trancaalex19/Prelucrarea-mecanic-i-simularea-CAM-pentru-un-cilindru-de-distribu-ie-/Proiect_Pi3.pdf

### Universitatea Nat, ională de S, tiint,ă s, i Tehnologie Politehnica din Bucureşti Facultatea de Inginerie Industrială şi Robotică

Specializarea Informatică Aplicată

# PROIECT DE PROCESE INDUSTRIALE

## Proiectarea procesului de fabricare a produsului: Cilindru de Distribut, ie cu Flans,ă

Student: Trancă Alexandru-Constantin
Grupa: 634 AB
Cadrul didactic: Sergiu TONOIU / Marius LAZAR˘

An univ. 2025-26

# Cuprins

## 1 Proiectare proces de fabricare a produsului

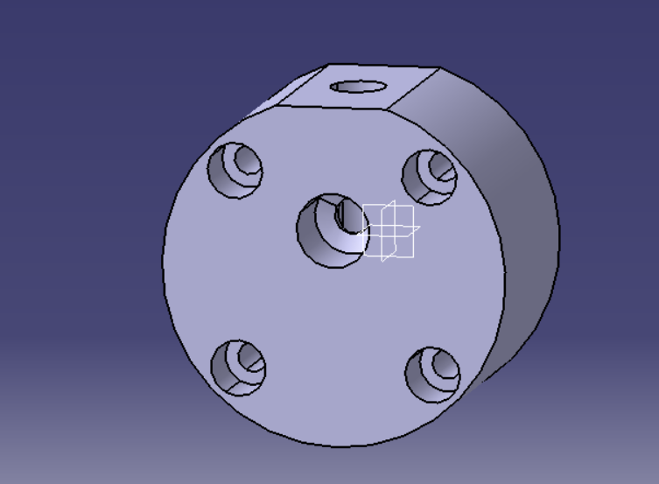
[picture p1: figure]

Figura 1: Model 3D - Cilindru de distribut, ie cu flans,ă

### 1.1 Date init¸iale generale

- Produs: Cilindru de distribut, ie cu flans,ă
- Programa de product, ie: 1250 buc/an
- Unitatea de product, ie: CRYSTAL S.A.
- Obiectiv principal: introducerea unei noi tehnologii
- Fond real de timp: 255 · 1 · 8 = 2040 ore/an
- Cerint,a economică: cost minim de product, ie

## 2 Date constructiv - funct¸ionale

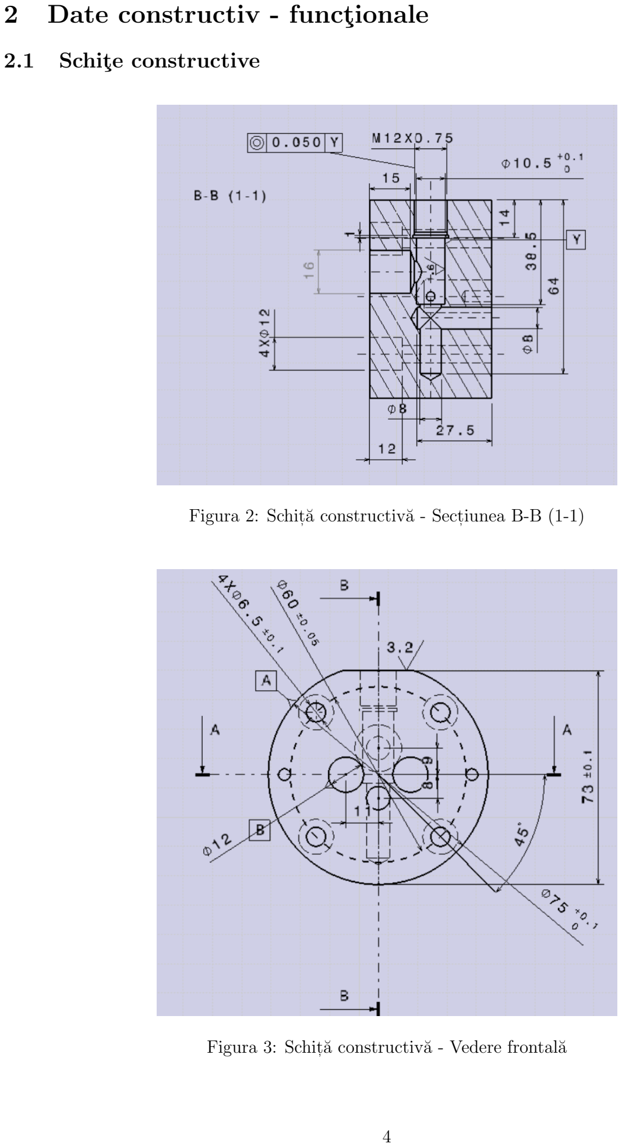
[picture p2: page 5]

### 2.1 Schitȩ constructive

Figura 2: Schit,ă constructivă - Sect, iunea B-B (1-1)

Figura 3: Schit,ă constructivă - Vedere frontală

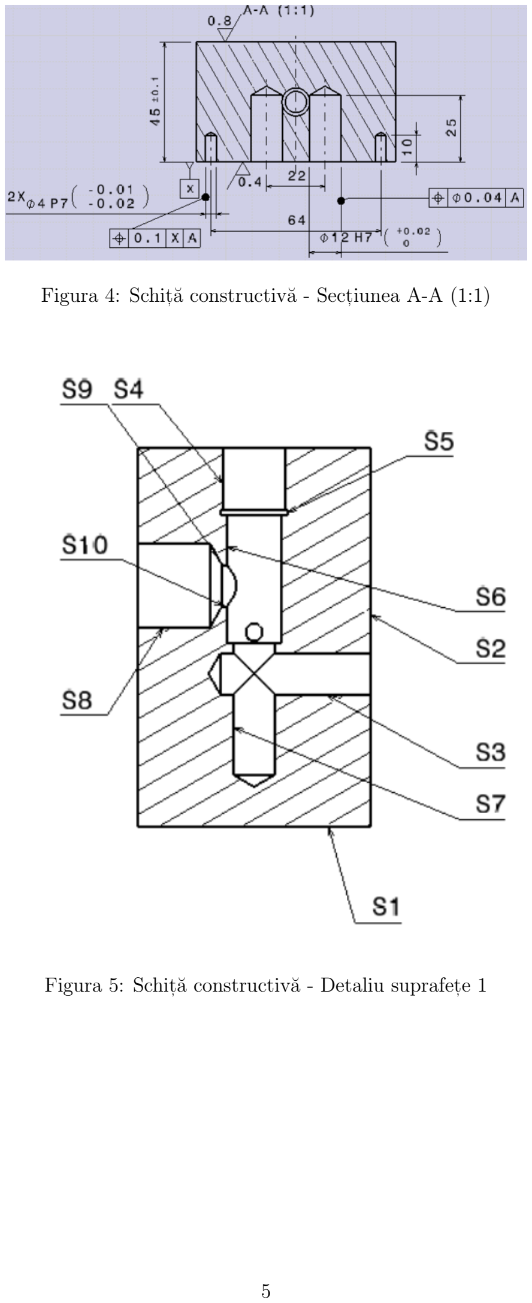
[picture p3: page 6]

Figura 4: Schit,ă constructivă - Sect, iunea A-A (1:1)

Figura 5: Schit,ă constructivă - Detaliu suprafet,e 1

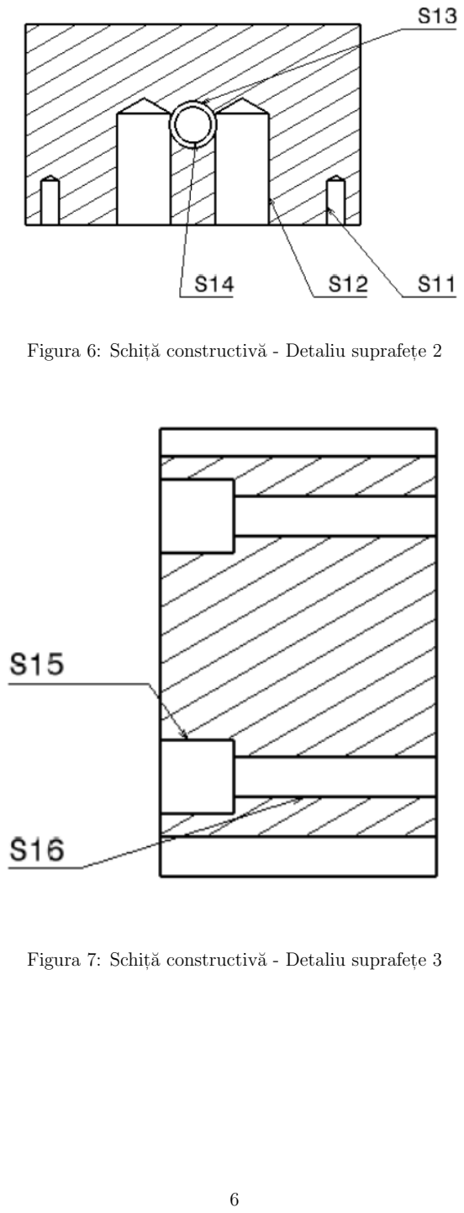
[picture p4: page 7]

Figura 6: Schit,ă constructivă - Detaliu suprafet,e 2

Figura 7: Schit,ă constructivă - Detaliu suprafet,e 3

### 2.2 Caracteristici constructive prescrise

a. Caracteristicile suprafetȩlor
SK | Forma | Precizie dimensională | Prec. formă | Ra | Prec. pozit, ie
S1 | Cilindrică Exteri-oară | 45+0.3 × ϕ75+0.1 −0.3 −0.0 mXm | - | 3.2 N8 | -
S2 | Plană Exterioară | ϕ73+0.1 × ϕ45+0.3 −0.1 −0.3 mXm | - | 0.8 N6 | -
S3 | Cilindrică Interi-oară | ϕ8 +0.2 × ϕ25+0.2 −0.2 −0.2 mXm | - | 6.3 N9 | -
S4 | Filetată Interioară | ϕ12+0.2 × ϕ0.75+0.1 −0.2 −0.1 mXm | - | 6.3 N9 | -
S5 | Cilindrică Interi-oară | ϕ13+0.2 +0.1 × 1 −0.2 −0.1 mXm | - | 6.3 N9 | ⊙|0.050|Y V III
S6 | Cilindrică Interi-oară | ϕ10.5 +0.1 × 24.5 +0.2 −0.0 −0.2 mXm | - | 1.6 N7 | -
S7 | Cilindrică Interi-oară | +0.2 × 26+0.2 ϕ8 −0.2 −0.2 mXm | - | 6.3 N9 | -
S8 | Filetată Interioară | ϕ16+0.2 +0.1 × ϕ1.5 −0.2 −0.1 mXm | - | 6.3 N9 | -
S9 | Conică Interioară | ϕ16+0.2 +0.2 × 8 −0.2 −0.2 mXm | - | 6.3 N9 | -
S10 | Cilindrică Interi-oară | +0.2 +0.2 ϕ8 × 3 −0.2 −0.2 mXm | - | 6.3 N9 | -
2xS11 | Cilindrică Interi-oară | −0.01 −0.02 × 10+0.2 ϕ4 −0.2 p7Xm | - | 6.3 N9 | -
2xS12 | Cilindrică Interi-oară | ϕ12+0.018 × 25+0.2 −0.000 −0.2 h7Xm | - | 6.3 N9 | ⊕|0.04|A V III
S13 | Rază interioară | R10.5 | - | 6.3 N9 | -
S14 | Cilindrică Interi-oară | +0.2 × 26+0.2 ϕ8 −0.2 −0.2 mXm | - | 6.3 N9 | -
4xS15 | Cilindrică Interi-oară | ϕ12+0.2 × 12+0.2 −0.2 −0.2 mXm | - | 6.3 N9 | -
4xS16 | Cilindrică Interi-oară | +0.1 × 33+0.2 ϕ6.5 −0.1 −0.2 mXm | - | 6.3 N9 | -

b. Tabel: Abateri limită pentru dimensiuni liniare cf. ISO 2768 - m
Clasa | Descriere | 0.5 - 6 mm | 6 - 30 mm | 30 - 120 mm | 120 - 400 mm
m | mijlocie | ±0.1 | ±0.2 | ±0.3 | ±0.5
c. Caracteristici de material
- Având în vedere preciziile dimensionale ridicate impuse (trepte de tolerant,ă IT7 s, i IT8), materialul ales este ot,elul de calitate nealiat C45 (echivalent OLC 45).
- Acesta este un ot,el de îmbunătăt, ire care permite obt, inerea unor suprafet,e cu rugozitate foarte mică prin rectificare.
- Compozit, ia chimică: Carbon (C): 0,42-0,50%; Mangan (Mn): 0,50-0,80%; Silicon (Si): max. 0,40%; Crom (Cr): max. 0,40%.
- Structura metalografică: În stare recoaptă: ferito-perlitică. După tratament termic (îmbunătăt, ire): sorbită de revenire, care asigură un echilibru optim între duritate s, i tenacitate, esent, ial pentru ment, inerea preciziei geometrice în timp.
- Proprietăt, i fizico-mecanice: Rezistent,a la tract, iune Rm: 580-700 MPa. Limita de curgere Re: min. 340 MPa. Duritate: aprox. 170-210 HB (stare recoaptă) sau peste 50 HRC (după călire superficială pe suprafet,ele funct, ionale).
- Tratamente termice prescrise: Normalizare: 840 − 880◦C.

Îmbunătăt, ire: Călire la 820 − 860◦C (în apă sau ulei) urmată de revenire la 550 − 660◦C.

d. Masa
•

În cadrul software-ului de modelare 3D (CATIA V5 / Fusion 360), am atribuit reperului materialul C45 (AISI 1045).

- Utilizând funct, ia Properties, au fost determinate caracteristicile fizice bazate pe densitatea de 7, 85 kg/dm³

(0, 00785 g/mm³
).
- Masa piesei este 172 de grame (0.172 kg) s, i a fost determinată cu ajutorul programului Catia V5 folosind unealta Measure Inertia.
- Volumul produsului: 45,04 cm³

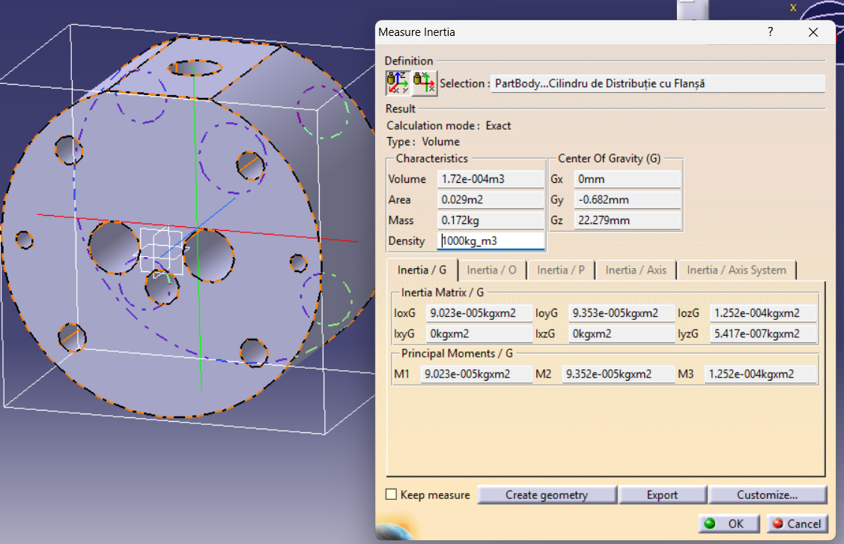
[picture p5: figure]

Figura 8: Determinarea masei utilizând Measure Inertia în CATIA V5

### 2.3 Tehnologicitate

Analiza tehnologicităt, ii piesei din C45 confirmă eficient,a procesului de fabricat, ie propus.
a. Concordant¸a dintre caracteristicile constructive s, i rolul funct¸ional
- Precizia dimensională: Utilizarea tolerant,elor strânse pentru cota fantei 4 P7 (treapta IT7) s, i a găurilor de ϕ12 H7 indică un rol funct, ional critic, piesa fiind destinată unui ansamblu cu ajustaje cu strângere sau centrare precisă.
- Calitatea suprafet,elor: Pentru suprafet,ele de precizie s-a impus o rugozitate de Ra 0,4 sau Ra 0,8. Aceasta este realizabilă prin operat, ii de finisare (rectificare), specifice ot,elului C45.
- Pozit, ia relativă: Tolerant,a de pozit, ie de 0,04 mm sau 0,1 mm fat,ă de baza A este justificată pentru a asigura coaxialitatea sau simetria elementelor fat,ă de axele de referint,ă.
b. Gradul de unificare a caracteristicilor geometrice
- Elemente standardizate: Utilizarea găurilor de ϕ6, 5 (cu tolerant,ă generală ±0.1) permite folosirea sculelor as,chietoare de serie.
- Cerc de divizare (PCD): Dispunerea elementelor pe un cerc de divizare punctat facilitează programarea pe mas, ini CNC în coordonate polare.
- Dimensiuni normale: Cotele liniare au fost alese din şirurile de dimensiuni normale (Anexa I), optimizând utilizarea semifabricatelor standard.
c. Propuneri de eliminare a deficientȩlor s, i concluzii
- Accesibilitatea aşchierii: Geometria permite accesul facil al sculelor pe vederile sect¸ionate (sect, iuni locale de tip breakout), fără necesitatea unor scule speciale.
- Propunere de optimizare: Se recomandă adăugarea unor tes, ituri de 1 × 45◦
la intrarea în
alezajele filetate (ex. M16) s, i la marginile exterioare pentru a facilita asamblarea s, i a proteja filetul de bavuri.

### 2.4 Clasa piesei

Conform desenului de execut, ie s, i caracteristicilor constructive, piesa analizată face parte din clasa elementelor de distribut, ie s, i flanşelor utilizate în cadrul sistemelor hidraulice sau pneumatice. Acest tip de piesă are rolul de a asigura închiderea, etanşarea s, i dirijarea precisă a fluidelor, contribuind la ment, inerea pozit, iei corecte a componentelor din ansamblu. De asemenea, piesa asigură centrarea s, i fixarea rigidă prin intermediul ajustajelor prescrise.

### 2.5 Analiza caracteristicilor funct, ionale ale piesei

### 2.5.1 Rolul funct, ional al piesei

Principalul rol al piesei ”

Cilindru de Distribut, ie cu Flanşă” este de a permite distribut, ia fluidului de lucru s, i de a asigura îmbinarea precisă cu restul ansamblului. Prin intermediul suprafet,elor de montaj (alezajele H7 s, i P7) s, i al găurilor de prindere, piesa se fixează pe corpul sistemului, realizând solidarizarea cu acesta.

### 2.5.2 Rolul funct, ional al suprafet,elor piesei s, i ajustaje prescrise

a) Rolul funct, ional al suprafet,elor piesei
În general, rolul funct, ional al piesei este determinat de rolul funct, ional al suprafet,elor care o compun. Principalele suprafet,e ale piesei s, i rolul acestora sunt prezentate în tabelul următor:
SK | Forma suprafet,ei | Rolul funct, ional
S1 | Cilindrică Exterioară | Suprafat,ă de centrare s, i delimitare construc-tivă a formei piesei.
S2 | Plană Exterioară | Suprafat,ă de sprijin s, i montaj pe corpul an-samblului.
S3, S6, S7, S10, S14 | Cilindrică Interioară | Suprafet,e funct, ionale pentru dirijarea fluidu-lui sau montajul componentelor interne.
S9 | Conică Interioară | Suprafet,e de racordare sau scaune pentru ele-mente de etanşare/supape.
S4, S8 | Filetată Interioară | Suprafet,e de fixare pentru elemente de prin-dere, fitinguri sau accesorii hidraulice.
S5 | Cilindrică Interioară | Suprafet,e tehnologice s, i funct, ionale pentru trecerea fluidului.
2xS11 | Cilindrică/Conică Int. | Suprafet,e de pozit, ionare s, i centrare precisă (s,tifturi de ghidare).
2xS12 | Cilindrică/Conică Int. | Suprafet,e funct, ionale cu tolerant,ă strânsă pentru asamblare s, i etanşare.

SK | Forma suprafet,ei | Rolul funct, ional
4xS15, 4xS16 | Cilindrică Interioară | Suprafet,e de fixare prin şuruburi pentru prin-derea flanşei de corp.
S13 | Rază interioară / De-gajare | Cameră de racordare pentru distribut, ia uni-formă a fluidului către canalele verticale.
S14 | Cilindrică Interioară | Galerie principală de alimentare pentru con-ducerea fluidului de lucru către zona de distribut, ie.
b) Ajustaje prescrise
Alezajele de precizie ϕ12 H7 s, i fantele/găurile ϕ4 P7 sunt critice pentru funct, ionarea sistemului.
- Tolerant,a H7 indică un ajustaj cu joc sau de trecere precisă, permit,ând centrarea corectă a componentelor pereche s, i reducerea frecării în timpul asamblării.
- Tolerant,a P7 indică un ajustaj cu strângere (sau de trecere fixă), utilizat pentru presarea s,tifturilor de centrare, garantând rigiditatea şi ment¸inerea pozit, iei relative.

2.5.3 Concordant¸a dintre caracteristicile prescrise s, i cele impuse de rolul funct¸ional

În urma analizei desenului de execut, ie s-a constatat că majoritatea caracteristicilor dimensionale s, i de precizie sunt în perfectă concordant¸ă cu rolul funct, ional al piesei. Suprafet,ele de asamblare prezintă tolerant,e strânse (IT7) s, i rugozităt, i fine (Ra 0.4, Ra 0.8), în timp ce pentru suprafet,ele de degajare sau constructive, tolerant,ele au fost relaxate. Prin urmare, caracteristicile prescrise sunt rat, ionale s, i corespunzătoare.

### 2.6 Analiza caracteristicilor tehnologice ale piesei

### 2.6.1 Prelucrabilitatea materialului

Materialul impus în construct, ia piesei este ot,el C45, conform standardului SR EN 10083. Acest tip de ot,el prezintă o rezistent,ă mecanică bună, duritate ridicată s, i o bună prelucrabilitate prin as,chiere. Acest material permite realizarea operat, iilor de strunjire, frezare, găurire s, i alezare în condit, ii tehnologice favorabile.

### 2.6.2 Forma constructivă a piesei

Piesa este compusă din forme geometrice relativ simple, principalele suprafet,e fiind cilindrice s, i plane. Cu toate acestea, prezent,a alezajelor radiale s, i a găurilor dispuse pe cercul de divizare impune utilizarea unor mas, ini cu comandă numerică (CNC) cu minim 3 axe, sau centre de strunjire-frezare.

### 2.6.3 Posibilitatea folosirii unor suprafet,e ca bază de referint,ă

În primele operat, ii de prelucrare, bazarea piesei se va realiza pe suprafet,ele cilindrice s, i plane exterioare ale semifabricatului. Ulterior, pentru obt, inerea preciziei de pozit, ie (0.04, 0.050), piesa va fi fixată utilizând suprafet,ele deja prelucrate (ex: suprafat,a frontală S5 s, i diametrul exterior S1), care vor servi drept baze tehnologice principale.

### 2.6.4 Analiza prescrierii rat, ionale a tolerant,elor

Tolerant,ele dimensionale sunt prescrise în mod rat, ional, fiind aplicate restrictiv doar pe suprafet,ele funct¸ionale (H7, P7). Suprafet,ele constructive exterioare au tolerant,e mai largi, ceea ce conduce la simplificarea procesului tehnologic, scăderea timpului de prelucrare s, i reducerea costurilor de fabricat, ie.

### 2.7 Gradul de unificare al caracteristicilor constructive

Gradul de unificare reprezintă un indice de tehnologicitate utilizat pentru aprecierea nivelului de standardizare al elementelor. Piesa are un grad excelent de unificare: găurile de ϕ6.5, filetele metrice fine standardizate s, i unghiurile de tes, ire de 120◦ permit utilizarea sculelor as,chietoare de serie (burghie, tarozi, tes, itoare standard), indicând o tehnologicitate favorabilă.

## 3 Semifabricare s, i prelucrări

### 3.1 Proiectarea semifabricatului

### 3.1.1 a) Alegerea metodei s, i justificarea procedeului

Având în vedere materialul Ot,el C45 s, i volumul de product, ie de serie medie (1250 buc/an), metoda optimă de obt, inere a semifabricatului este deformarea plastică, mai exact procedeul de matrit,are la cald în matrit,e închise.
Spre deosebire de piesele turnate din fontă, ot,elul carbon de calitate C45 se pretează excelent la deformare plastică la cald. Alegerea matrit,ării este justificată din următoarele considerente tehnico-economice:
- Precizie geometrică ridicată: Asigură obt, inerea unei configurat, ii foarte apropiate de forma finală a piesei (cilindru cu flans,ă), reducând astfel semnificativ adaosurile de prelucrare s, i volumul de material îndepărtat prin as,chiere ulterioară.
- Caracteristici mecanice superioare: Prin presarea materialuluiîn matrit,ă se obt, ine o structură internă omogenă s, i o fibrare continuă, care urmăres,te conturul piesei. Acest aspect cres,te rezistent,a la uzură s, i oboseală, esent, ială pentru rolul funct, ional al cilindrului de distribut, ie.
- Eficient,ă economică: Pentru seria de 1250 bucăt, i/an, costul de proiectare s, i execut, ie a matrit,elor se amortizează rapid prin economia de material s, i reducerea drastică a timpilor auxiliari s, i de as,chiere pe mas, inile CNC.

În faza de fundamentare a deciziei tehnologice, au fost luate în calcul două variante tehnic acceptabile pentru obt, inerea semifabricatului. Acestea sunt detaliate în Tabelul 3.1.a. S-a optat definitiv pentru Varianta 1.

Tabela 3: Tab. 3.1.a Metoda s, i procedeul de semifabricare

Varianta | Tip semifabricat | Metoda de semifa-bricare | Procedeu de semifa-bricare
1 | Cu adaos mare (Precizie normală) | Deformare plastică | Matrit,are la cald pe cio-can
2 | Cu adaos foarte mare (Precizie brută) | Deformare plastică | Forjare liberă pe ciocan

### 3.1.2 b) Reprezentarea grafică a semifabricatului

Pentru obt, inerea formei brute s-au stabilit adaosurile de prelucrare, adaosurile tehnologice (pentru suprafet,ele care se vor prelucra din plin, cum ar fi alezajele mici sau filetele) s, i razele de racordare constructive. Planul de separat, ie al matrit,ei a fost plasat la nivelul sect, iunii maxime (flans,a). În figurile de mai jos sunt prezentate schit,ele tehnologice ale semifabricatului brut matrit,at.

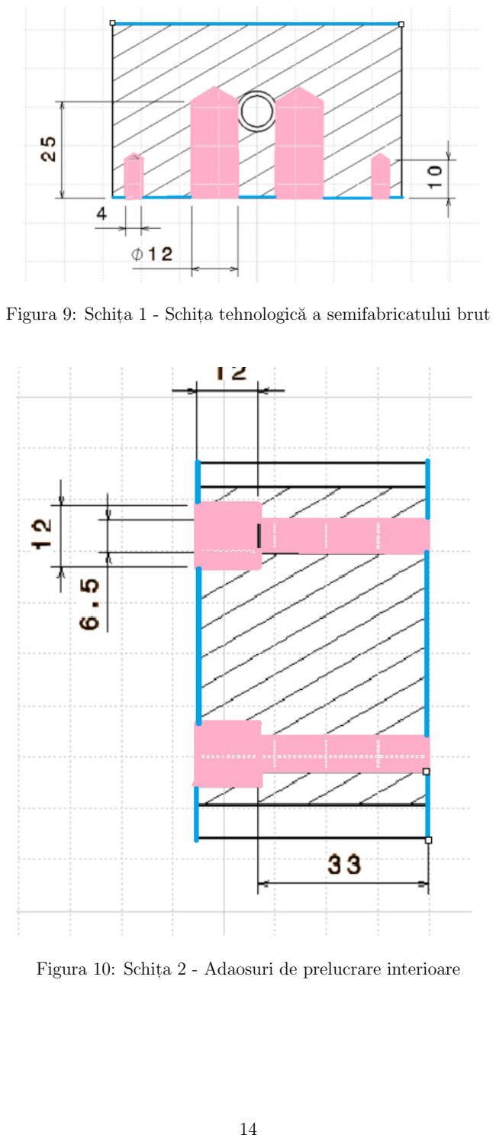
[picture p6: page 15]

Figura 9: Schit,a 1 - Schit,a tehnologică a semifabricatului brut

Figura 10: Schit,a 2 - Adaosuri de prelucrare interioare

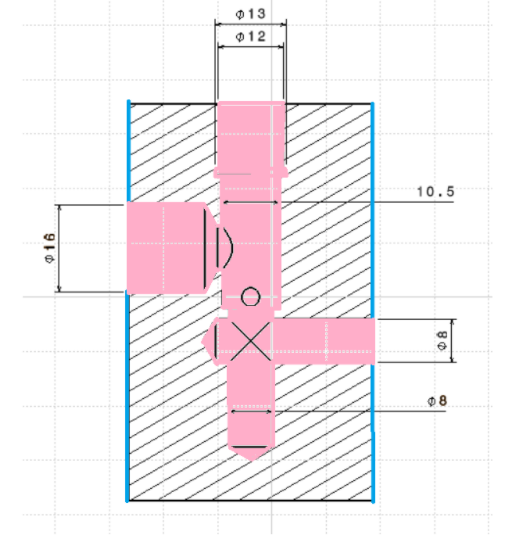
[picture p7: figure]

Figura 11: Schit,a 3 - Definirea cotelor brute finale

### 3.1.3 c) Determinarea adaosurilor de prelucrare

În Tabelul 3.1.b se prezintă principalele dimensiuni ale suprafet,elor semifabricatului cu adaosurile specifice matrit,ării pe ciocan (conform SR EN 10243), metodă aleasă pentru reducerea costurilor de pregătire a fabricat, iei.

Tab. 3.1.b Caracteristicile semifabricatului

Suprafat,a | Dimensiunea pre-scrisă piesei [mm] | Adaosul de prelu-crare total [mm] | Dimensiunea pre-scrisă semifabricatu-lui [mm]
Lungime to-tală | 64 | - | Se prelucrează din plin
Găuri de de-gajare | ϕ16, ϕ8 | - | Se prelucrează din plin
Gaură de fi-xare | ϕ4 | - | Se prelucrează din plin
Gaură de fi-xare | ϕ12, ϕ4, filet M12 | 2 pe rază | ϕ12+0.018 −0.000

### 3.2 Prelucrări

### 3.2.1 Stabilirea succesiunii de prelucrări

a) Date init, iale:
- Tipul s, i caracteristicile suprafet,elor: Conform analizei suprafet,elor (Tabelul caracteristicilor SK) din desenul de execut, ie (suprafet,e cilindrice exterioare, interioare de ghidare, suprafet,e plane de as,ezare s, i suprafet,e filetate).
- Precizia prescrisă fiecărei suprafet,e: Conform desenului de execut, ie, sunt impuse tolerant,e dimensionale strânse, în special clasa H7 (pentru alezajul central ϕ12) s, i clasa P7 (pentru găurile de fixare ϕ4), dar s, i rugozităt, i foarte fine de până la Ra 0.4 µm (pentru cota H7) s, i Ra 0.8 µm (pentru planul flans,ei).
- Materialul: Ot,el de calitate nealiat C45, care prezintă o bună prelucrabilitate pentru atingerea rugozităt, ilor impuse.
- Programa de product, ie: 1250 buc/an (serie mijlocie).
- Semifabricat: Obt, inut prin deformare plastică (Matrit,are la cald pe ciocan - varianta cu adaos mare), conform subcapitolului precedent. De ment, ionat că alezajele de precizie s, i filetele vor fi prelucrate din plin, neavând goluri în semifabricatul brut.
- Metodologia de stabilire: S-a renunt,at la metoda analitică a coeficient, ilor de precizie în favoarea stabilirii directe a succesiunii operat, iilor, utilizând preciziile economice ale metodelor de prelucrare prin as,chiere (conform tabelelor de recomandări tehnologice).
b) Stabilirea prelucrărilor necesare (Metoda preciziei economice)
Pornind de la starea suprafet,elor semifabricatului matrit,at, prelucrările au fost stabilite astfel încât să se atingă treptat clasa de tolerant,ă s, i rugozitatea finală cerută pe desen. Din perspectiva prelucrării pe centre CNC moderne, s-au respectat următoarele recomandări tehnologice stricte pentru prelucrarea ot,elului C45:
- Pentru suprafet,ele cilindrice s, i plane de precizie normală, se va aplica o prelucrare de degros,are pentru îndepărtarea crustei de matrit,are, urmată de o trecere de finisare.
- Pentru suprafat,a frontală de as,ezare (S2), unde este impusă o rugozitate fină de Ra 0.8 µm, succesiunea necesită 3 treceri: Strunjire frontală de degros,are, semifinisare s, i o trecere finală de finisare.
- Pentru alezajele de mare precizie (ϕ12 H7 s, i ϕ4 P7), trecerea de la material plin la cota finală necesită prelucrări succesive pentru a garanta respectarea tolerant,ei s, i rugozităt, ii fine (Ra 0.4): Găurire cu burghiu subcotat, urmată de Alezare de degros,are s, i Alezare de precizie (finisare).
- Pentru suprafet,ele filetate (M12 × 0.75 s, i M16 × 1.5), procesul va fi: Găurire la diametrul prescris, tes, ire de intrare, urmată de Filetare cu tarod.
- Suprafet,ele de degajare interioare conice s, i razele (S9, S13) se vor prelucra prin strunjire de conturare (interpolare CNC pe 2 axe).

În Tabelul 3.2.1 se prezintă sinteza prelucrărilor necesare pentru îndeplinirea caracteristicilor tuturor celor 16 suprafet,e ale cilindrului de distribut, ie.

Tab. 3.2.1 Stabilirea prelucrărilor principale pentru toate suprafet,ele

Nr. Supr. | Forma nominală | Prel. 1 | Prelucrări / Ra [µm] Prel. 2 | Prel. 3
S1 | Suprafat,ă cilindrică exterioară (ϕ75) | Strunjire exterioară de degros,are 12.5 IT10 | Strunjire exterioară de finisare 3.2 IT9 | -
S2 | Suprafat,ă plană ex-terioară (Flans,ă) | Strunjire frontală de degros,are 12.5 IT10 | Strunjire frontală de semifinisare 3.2 IT9 | Strunjire fron-tală de finisare 0.8 IT7
S3 | Suprafat,ă cilindrică interioară (ϕ25) | Găurire din plin / Lărgire 12.5 IT12 | Strunjire interioară de finisare 6.3 IT10 | -
S4, S8 | Suprafet,e filetate interioare (M12, M16) | Găurire din plin (ϕ11.2 / ϕ14.5) 12.5 IT12 | Tes, ire intrare 1 × 45◦ 6.3 IT10 | Filetare cu tarod 3.2 IT9
S5 | Suprafat,ă cilindrică interioară (ϕ13) | Găurire din plin 12.5 IT12 | Strunjire interioară de degros,are 6.3 IT10 | -
S6 | Suprafat,ă cilindrică interioară (ϕ10.5) | Găurire din plin (ϕ10) 12.5 IT12 | Strunjire interioară de finisare 1.6 IT8 | -
S7, S10, S14 | Suprafet,e cilindrice interioare (ϕ8) | Găurire din plin (ϕ8) 6.3 IT11 | - -
S9 | Suprafat,ă conică interioară | Strunjire conică de degros,are 12.5 IT10 | Strunjire conică de finisare 6.3 IT9 | -
S11 (2x) | Suprafat,ă cilindrică interioară (ϕ4 P7) | Găurire din plin (ϕ3.8) 12.5 IT12 | Alezare de finisare 1.6 IT7(P7) | -

Nr. Supr. | Forma nominală | Prel. 1 | Prelucrări / Ra [µm] Prel. 2 | Prel. 3
S12 (2x) | Suprafat,ă cilindrică interioară (ϕ12 H7) | Găurire din plin (ϕ11.8) 12.5 IT12 | Alezare de degros,are 3.2 IT9 | Alezare de fini-sare 0.4 IT7(H7)
S13 | Rază interioară de racordare (R10.5) | Strunjire conturare de degros,are 12.5 IT10 | Strunjire conturare de finisare 6.3 IT9 | -
S15 (4x) | Degajări cilindrice interioare (ϕ12) | Lărgire / Frezare prin interpolare 6.3 IT10 | - -
S16 (4x) | Găuri fixare (ϕ6.5) | Găurire din plin (ϕ6.5) 6.3 IT11 | - -

## 4 Procese tehnologice de referint,ă

Procesul tehnologic reprezintă coloana vertebrală a oricărui flux de product, ie industrială, fiind definit ca ansamblul ordonat al operat, iilor de transformare prin care un semifabricat (în cazul nostru, piesa matrit,ată din ot,el C45) este convertit într-un produs finit ce respectă riguros condit, iile de formă, dimensiune s, i calitate a suprafet,ei. Elaborarea acestuia pentru reperul ”

Cilindru de Distribut, ie
cu Flans,ă” se fundamentează pe o analiză complexă a interact, iunii dintre caracteristicile mecanice superioare ale materialului C45 s, i preciziile dimensionale ridicate impuse de ajustajele H7 s, i P7. Având în vedere programa de product, ie stabilită la 1250 bucăt, i pe an, procesul tehnologic trebuie să asigure un echilibru optim între precizia tehnică s, i rentabilitatea economică.

### 4.1 Principiile generale care stau la baza proiectării proceselor tehnolo-

### gice

Proiectarea structurii procesului tehnologic pentru piesa de fat,ă urmează o serie de norme s, i principii tehnico-economice fundamentale, extrase din literatura de specialitate s, i adaptate dotărilor tehnice ale unităt, ii S.C. CRYSTAL S.A.. Am integrat următoarele direct, ii directoare:

- Principiul suprapunerii bazelor tehnologice cu bazele de cotare: Aceasta este ” regula
de aur” în prelucrările mecanice de precizie. Prin utilizarea aceleias, i suprafet,e atât pentru orientarea s, i fixarea în dispozitiv (bază tehnologică), cât s, i pentru măsurarea cotelor (bază de cotare), se elimină complet erorile matematice de transfer de baze. De exemplu, cotele axiale ale cilindrului sunt raportate direct la fat,a frontală a flans,ei (Baza A), garantând respectarea tolerant,elor de lungime.
- Principiul unicităt, ii s, i constant,ei bazelor: Se urmăres,te ca un număr cât mai mare de suprafet,e funct, ionale să fie prelucrate folosind aceleas, i suprafet,e de referint,ă. Prin finisarea timpurie a bazelor A s, i B, acestea servesc drept suport pentru toate fazele de găurire s, i alezare, asigurând perpendicularitatea s, i coaxialitatea elementelor.
- Succesiunea operat, iilor în funct, ie de gradul de precizie: Prelucrările sunt programate logic, începând cu degros,area suprafet,elor brute (unde se îndepărtează stratul de oxizi s, i se eliberează tensiunile interne ale ot,elului C45), continuând cu semifinisarea s, i finalizând cu operat, iile de mare precizie (IT7, Ra 0.4). Această ierarhie protejează sculele de finisat scumpe s, i previne deformarea suprafet,elor gata finisate sub influent,a fort,elor de as,chiere mari de la început.
- Descoperirea defectelor interne ale materialului: Deoarece piesa este obt, inută prin matrit,are la cald, pot apărea discontinuităt, i structurale. Prima operat, ie de strunjire interioară are s, i rolul de ”

sondă”, permit,ând identificarea eventualelor defecte de turnare/matrit,are înainte de a investi resurse suplimentare în piesa respectivă.

- Principiul concentrării activităt, ilor tehnologice: Pentru o product, ie de serie medie, s-a optat pentru utilizarea centrelor CNC care permit executarea a peste 80% din fazele de as,chiere (strunjire, frezare, filetare) dintr-o singură orientare-fixare. Concentrarea reduce drastic timpii mort, i de transport s, i as,teptare, minimizând totodată riscul de marcare a suprafet,elor la manipulări repetate.
- Minimalizarea curselor în gol: Proiectarea traseelor de sculă prin programele CAM se face astfel încât timpii de pozit, ionare fără as,chiere să fie redus, i la minim. Această optimizare este vitală pentru scăderea timpului de ciclu s, i, implicit, a costului de fabricat, ie pe unitate de produs.

### 4.2 Procesul tehnologic tip pentru piese din clasa flans,ă-bucs,ă

Pentru piese cu geometrie complexă de revolut, ie prevăzute cu alezaje s, i filete multiple, literatura de specialitate oferă un itinerar tehnologic de referint,ă, pe care l-am extins pentru a acoperi particularităt, ile cilindrului de distribut, ie:

1. Pregătirea bazelor de referint,ă tehnologică: Strunjirea de degros,are a fet,ei frontale s, i a diametrului exterior maxim pentru a asigura o as,ezare stabilă s, i precisă în universalul mas, inii;
2. Prelucrarea nucleului interior: Executarea alezajului central prin găurire s, i strunjire interioară. Această etapă eliberează tensiunile radiale din semifabricatul matrit,at;
3. Definirea treptelor exterioare: Strunjirea de degros,are s, i semifinisare a gulerului s, i a flans,ei, lăsând adaosurile de prelucrare necesare pentru atingerea rugozităt, ii finale de Ra 0.8;
4. Prelucrarea suprafet,elor auxiliare secundare: Executarea canalelor de degajare, a razelor de racordare de R3 s, i a tes, iturilor constructive;
5. Configurarea elementelor axiale pe cercul de divizare: Găurirea celor 4 orificii de Ø6.5 pe cercul de divizare Ø60. Se utilizează interpolarea circulară CNC pentru a garanta precizia pozit, ionării;
6. Finisarea de înaltă precizie a ajustajelor: Alezarea finală a găurilor Ø4 P7 s, i a alezajului central Ø12 H7. Se aplică regimuri de as,chiere cu avansuri reduse pentru a atinge rugozitatea critică de Ra 0.4;
7. Executarea filetelor interioare: Filetarea M12x0.75 s, i M16x1.5. Utilizarea tarozilor de mas, ină pe centre CNC garantează coaxialitatea filetului cu suprafet,ele de sprijin;
8. Tratament termic de îmbunătăt, ire (după caz): Pentru materialul C45, se poate aplica o călire urmată de revenire înaltă pentru a optimiza raportul duritate/tenacitate, etapă urmată obligatoriu de rectificare;
9. Inspect, ia tehnică finală (C.T.F.): Verificarea finală a tuturor parametrilor geometrici s, i dimensionali utilizând micrometre, calibre tampon s, i rugozimetre digitale.

### 4.3 Justificarea procesului tehnologic existent s, i propus

Pentru reperul ”

Cilindru de Distribut, ie cu Flans,ă”, nu s-a identificat un proces tehnologic anterior aplicat, fapt ce a permis proiectarea unei variante moderne bazate pe tehnologia de prelucrare numerică. Această strategie este justificată prin următoarele considerente:

1. Stabilitatea procesului: Mas, inile CNC asigură o repetabilitate a cotelor pe care un strung universal nu o poate oferi în regim de serie medie (1250 buc/an), eliminând variat, iile cauzate de factorul uman.
2. Atingerea rugozităt, ilor impuse: Obt, inerea rugozităt, ii de Ra 0.4 pe material C45 necesită viteze de as,chiere s, i avansuri controlate electronic, imposibil de ment, inut manual pe toată durata seriei.
3. Eficient,a economică globală: Des, i costul orar al unui centru CNC este mai ridicat, reducerea numărului de prinderi (de la 6 prinderi pe mas, ini clasice la doar 2 pe CNC) conduce la un cost total per piesă mult mai scăzut.
În concluzie, prezentul capitol demonstrează că procesul tehnologic propus integrează cunos,tint,ele teoretice cu nevoile practice, oferind o solut, ie tehnică de referint,ă pentru prelucrarea eficientă a ot,elului carbon de calitate.

## 5 Structura preliminara a procesului tehnologic

### 5.1 Analiza principalelor restrictii privind continutul si succesiunea operatiilor

Proiectarea procesului tehnologic pentru reperul ”

Cilindru de Distribut, ie cu Flans,ă” s-a realizat având la bază principiul concentrării operat, iilor, utilizând mas, ini-unelte cu comandă numerică (CNC). Această abordare permite obt, inerea unei productivităt, i ridicate s, i respectarea cerint,elor de precizie, minimizând calculele analitice complexe de adaosuri economice în favoarea unui ciclu CNC optimizat. Stabilirea succesiunii fazelor s, i operat, iilor a respectat următoarele restrict, ii s, i reguli tehnologice fundamentale:

- Regula bazelor de referint,ă (orientare s, i fixare): Pentru prima operat, ie, aşezarea s, i strângerea piesei se fac obligatoriu pe suprafet,e brute (neprelucrate), ale cilindrului de laminare (ex: suprafat,a exterioară ϕ85 brută). Pentru toate operat, iile ulterioare, as,ezarea s, i strângerea se vor face obligatoriu pe suprafet,e prelucrate anterior.
- Regula preciziei de pozit, ie relativă: Suprafet,ele care au prescrise tolerant,e de pozit, ie sau orientare foarte strânse între ele (de exemplu perpendicularitate, bătaie radială ⊙0.050 Y sau pozit¸ie ⊕0.04 A) se vor prelucra, pe cât posibil, în aceeas, i operat, ie (la aceeas, i prindere). Dacă acest lucru nu este posibil din considerente de acces al sculei, ele se vor prelucra orientând piesa strict după baza de referint,ă indicată pe desen, care a fost deja finisată anterior.
- Aşezarea prelucrărilor de degroşare s, i finisare: Fazele de strunjire se execută la începutul procesului pentru a elimina grosul adaosului de prelucrare s, i stratul dur superficial din laminarea ot,elului C45. Fazele de finisare se grupează la finalul operat, iei, după degros,ări, pentru a garanta rugozităt, ile (Ra 0.4, Ra 0.8) s, i clasele de tolerant,ă (H7, P7).
- Regula cotelor intermediare: Pe schit,ele de operat, ie, cotele care reprezintă dimensiuni intermediare de prelucrare (care mai au adaos s, i vor mai fi prelucrate) se vor nota cu o bară deasupra. Cotele care reprezintă dimensiunea finală prescrisă pe desenul de execut, ie se vor nota normal, fără bară.
- Regula reprezentării grafice: Schitȩle de operat, ie vor reprezenta piesa simplificat, indicând doar bazele de aşezare (simbolizate standard), fort,ele de strângere s, i suprafet,ele prelucrate în operat, ia respectivă (marcate cu linie continuă groasă). Nu se vor desena sculele as,chietoare. Se vor cota exclusiv suprafet,ele care se prelucrează efectiv în acea fază.

Tab. 5.1 Restrictii operatii si faze

Restrict¸ii | privind
cont¸inutul | pri-
mei | operat¸ii | şi
al | următoarelor
(2-3) | denumite
OPERAT, II | DE
ÎNCEPUT

Restrict¸ii privind
cont¸inutul detaliat
al | operat¸iilor | şi
fazelor

Restrict¸ii privind
pozit, ia-succesiunea
realizării unor prelucrări, suprafetȩ
şi operat¸ii complementare
Restrict¸ii | referi-
toare | la | alegerea
suprafetȩi(lor)
tehnologice (de
aşezare) la prima
operat¸ie de prelucrare
1. În prima operat, ie
se | prelucrează
suprafetȩle | care
satisfac | simultan
următoarele cerintȩ:
- sunt pozit¸ionate în
raport de suprafetȩle
brute şi permit astfel
realizarea condit¸iilor
prescrise în raport cu
acestea;
- poate fi suprafat¸a
tehnologică pentru a
participa la orientarea
s, i fixarea piesei la
cât mai multe dintre
operat, iile următoare,
cu diametrul cel mai
mare şi asigură, astfel
ca suprafet,e tehnologice, realizarea unei
orientări sigure pentru
a doua şi pentru restul
operat, iilor;
- suprafat¸a care se
prelucrează în prima
operat¸ie şi care urmează să fie aleasă ca
suprafat,ă tehnologică,
trebuie să fie aceea
care asigură o aşezare
bună – cea mai stabilă
şi un adaos de prelucrare uniform pe toate
suprafet,ele | care | se
prelucrează ulterior.
1. Cont¸inutul
operat, iilor trebuie
să fie în concordant¸ă
cu prelucrările stabilite pentru fiecare
operat, ie.
2. Succesiunea fazelor
în cadrul operat¸iilor
să fie, ca natură,
cea dată de ordinea
prelucrărilor.
3. Succesiunea pre-
lucrării | suprafetȩlor
în | cadrul | fazelor
trebuie | să | permită
îndepărtarea adaosu-
rilor | de | prelucrare,
evacuarea | aşchiilor
din zona de lucru,
evitarea intersectării
sculelor, realizarea
uşoară a suprafetȩlor.
1. | Pozit, ia | pre-
lucrărilor de degroşare
şi de finisare. | În
cadrul | proceselor
tehnologice | proiec-
tate | pe | principiul
diferent, ierii | pre-
lucrărilor, prelucrările
de | degroşare, | care
generează deformat, ii
elastice | şi | termice
mari, se repartizează
în operat, ii distincte
s, i se prevăd a fi
realizate înaintea
operat, iilor în care se
execută prelucrările
de finisare.
- Suprafetȩle tehnologice sunt suprafetȩ
ale piesei alese de
inginerul tehnolog,
pentru a fi de con-
tact | cu | suprafetȩle
elementelor | sistemu-
lui | tehnologic | care
realizează | orientarea
piesei | în | sistemul
tehnologic, în vederea
realizării operat¸iilor
s, i fazelor tehnologice
(prelucrare, control,
asamblare etc.)

Schemele de orientare
şi fixare reprezintă un
concept care indică
posibilităt¸ile | de | a
realiza | orientarea
s, i fixarea piesei la
o fază sau operat, ie
tehnologică din punct
de vedere al tipurilor
de reazeme utilizate
şi deci al suprafet,elor
piesei cu care acestea vin în contact
(denumite | suprafetȩ
tehnologice) | s, i | al
numărului de grade
de | libertate | prelu-
ate piesei de fiecare
reazem.

Restrict¸ii | privind
cont¸inutul | pri-
mei | operat¸ii | şi
al | următoarelor
(2-3) | denumite
OPERAT, II | DE
ÎNCEPUT

Restrict¸ii privind
cont¸inutul detaliat
al | operat¸iilor | şi
fazelor

Restrict¸ii privind
pozit, ia-succesiunea
realizării unor prelucrări, suprafetȩ
şi operat¸ii complementare
Restrict¸ii | referi-
toare | la | alegerea
suprafetȩi(lor)
tehnologice (de
aşezare) la prima
operat¸ie de prelucrare
2. În a doua şi a
treia operat, ie se pre-
lucrează: | suprafetȩ
cu | caracteristici
asemănătoare | ce-
lor | de | la | prima
operat, ie dar care pot
fi alese ca suprafetȩ
tehnologice | pentru
completarea | siste-
mului | suprafetȩlor
tehnologice care va
permite, împreună cu
suprafetȩle de orientare ale reazemelor,
orientarea completă a
piesei prin preluarea
numărului maxim de
grade | de | libertate
impus de condit, iile la
celelalte operat, ii.
4. Suprafetȩle pentru
care | sunt | prescrise
condit, ii | severe | de
pozit, ie | reciprocă
(pozit¸ie | nominală,
coaxialitate s, i concentricitate, simetrie,
paralelism, perpendicularitate, înclinare
şi bătaie) se vor prelucra, de regulă, în
aceeaşi orientare şi
fixare / pozit, ionare.
2. Pozit, ia suprafetȩlor
precise. | Suprafetȩle
cu | precizie | dimen-
sională şi geometrică
mare | s, i | rugozitate
mică, se finisează în
ultima operat¸ie.
3. | Pozit, ia | pre-
lucrărilor | unor

”

suprafetȩ | finale”.
Prelucrările | unor
suprafet,e | tip | găuri
de | şuruburi, | găuri
de strunjire, orificiile
plăcilor active, cavităt¸i, canale de pană, danturi etc., se prevăd
după prelucrările de
semifinisare (şi unele
chiar | de | finisare)
ale | suprafetȩlor | de
referint,ă ale acestora
(suprafetȩle plane ale
plăcilor, suprafetȩle
cilindrice, conice etc.).
Privind | alegerea
suprafet,elor | tehno-
logice | şi | schemelor
de orientare s, i fi-
xare | (SOF), | se
recomandă | respec-
tarea | următoarelor
restrict, ii:

R1. Restrict¸ia referitoare la alegerea
suprafet,ei(lor) tehnologice (de aşezare!)
la prima operat, ie de
prelucrare. La prima
operat, ie de prelucrare
se alege ca suprafat,ă
tehnologică una dintre
suprafet,ele piesei care
poate îndeplini simultan cât mai multe
dintre | următoarele
caracteristici | (dacă
este posibil pe toate):
rămâne brută, deci
nu se prelucrează, are
dimensiunile caracteristice cele mai mari,
permite prelucrarea,
în prima operat, ie, a
unei suprafet,e (sau a
mai multor suprafet,e)
tehnologice ce poate
fi utilizată (te) la
orientarea piesei în
oper. 2.

Restrict¸ii | privind
cont¸inutul | pri-
mei | operat¸ii | şi
al | următoarelor
(2-3) | denumite
OPERAT, II | DE
ÎNCEPUT

Restrict¸ii privind
cont¸inutul detaliat
al | operat¸iilor | şi
fazelor

Restrict¸ii privind
pozit, ia-succesiunea
realizării unor prelucrări, suprafetȩ
şi operat¸ii complementare
Restrict¸ii | referi-
toare | la | alegerea
suprafetȩi(lor)
tehnologice (de
aşezare) la prima
operat¸ie de prelucrare
3. Cont, inutul
operat¸iilor de început
trebuie astfel stabilit încât să permită
obt¸inerea unui pro-
ces | tehnologic | cu
un număr minim de
operat¸ii şi scheme de
orientare-fixare, dacă
se poate o singură
schemă pentru toate
operat, iile procesului
tehnologic.
5. Cont¸inutul
operat, iilor | şi | faze-
lor se stabileşte astfel
încât lungimea curselor active ale sculelor
s, i a celor de mers în
gol să fie minimă.
4. Pozit, ia operat¸iilor
complementare.
Operat, iile complementare (de control,
de | demagnetizare,
spălare, | debavurare)
se prevăd funct, ie de
rolul acestora, respectiv: operat, iile de
debavurare se prevăd
înaintea operat, iilor a
căror precizie poate
fi | influent¸ată | de
existent¸a | bavurilor;
operat, iile de control
se prevăd după fiecare
operat, ie | complexă,
după | un | grup | de
operat, ii | simple | s, i
ca | operat, ii | finale,
respectiv după eta-
pele | principale | ale
prelucrării; | după
degroşare, după se-
mifinisare | şi | după
finisare.
R2. | Restrict¸ia
referitoare | la | ne-
cesitatea | aşezării
piesei | numai | pe
suprafet,e prelucrate,
la | toate | operat, iile
procesului | tehno-
logic, | cu | except, ia
operat, iilor ”

de inceput”. As,ezarea piesei,
la | toate | operat, iile
procesului, | trebuie
să se facă numai pe
suprafetȩ prelucrate.
Se exceptează prima
operat, ie, pentru care
nu există suprafetȩ
prelucrate.

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

Restrict¸ii privind
cont¸inutul detaliat
al | operat¸iilor | şi
fazelor

Restrict¸ii privind
pozit, ia-succesiunea
realizării unor prelucrări, suprafetȩ
şi operat¸ii complementare
Restrict¸ii | referi-
toare | la | alegerea
suprafetȩi(lor)
tehnologice (de
aşezare) la prima
operat¸ie de prelucrare
Schema | generală | a
structurii unui proces tehnologic. Pe
baza acestor restrict, ii
se | recomandă | ca
schema | generală | a
oricărui proces să fie
următoarea:
1. Prelucrarea
suprafetȩlor alese ca
suprafetȩ tehnologice
pentru | operat¸iile
ulterioare, dacă este
posibil pentru toate.
2. Prelucrarea de degroşare a suprafetȩlor
cu | rol | funct¸ional
deosebit - denumite
suprafetȩ principale.
3. Prelucrarea de degroşare a suprafetȩlor
cu rol funct¸ional mai
scăzut | - | denumite
suprafetȩ secundare.
4. Prelucrarea de
finisare a suprafet,elor
principale.
5. Prelucrarea de
finisare a suprafet,elor
secundare.
6. Realizarea pre-
lucrărilor | de | tra-
tament | termic | de
durificare.
7. Prelucrarea de
superfinisare, prin
procedee abrazive sau
neconvent, ionale, | a
suprafetȩlor | princi-
pale.
R3. | Restrict¸ia refe-
ritoare | la | numărul
minim al schemelor de
orientare s, i fixare, sau

”

Principiul unicităt¸ii
suprafetȩlor | tehno-
logice”. | Numărul
schemelor de orientare
s, i fixare, pentru toate
operat, iile procesului,
trebuie | să | fie | mi-
nim, teoretic impune
utilizarea aceloras, i
suprafetȩ tehnologice
pentru realizarea
orientării piesei la un
număr cât mai mare
de operat, ii.

R4. Restrict¸ia referitoare la alegerea
suprafetȩlor | teh-
nologice, | respectiv
a | bazelor | asociate
acestora, în vederea
stabilirii | schemei
de orientare s, i fixare pentru fiecare
operat, ie.

### 5.2 Structura simplificata a proceselor si sistemelor de productie

În conformitate cu principiile de concentrare a fazelor pe mas, ini-unelte cu comandă numerică, itinerariul tehnologic pentru piesa ”

Cilindru de Distribut, ie cu Flans,ă” este prezentat în tabelul de mai jos.

Tabelul 5.2. Planul de operat, ii (Sinteza itinerariului tehnologic)

Numărul de or-dine s, i denumi-rea operat, iei | Schit,a simplificată a operat, iei | Utilaj, dispozitive, scule s, i SDV-uri (tip)

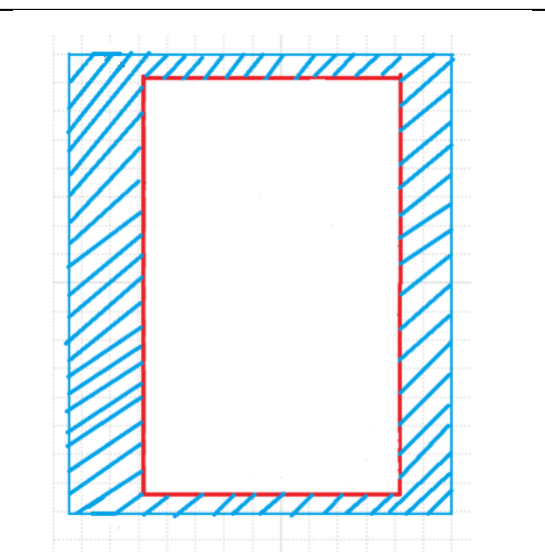
[picture p8: figure]

00 - Laminare | | U: Cilindru de laminare S: -D: -V: -

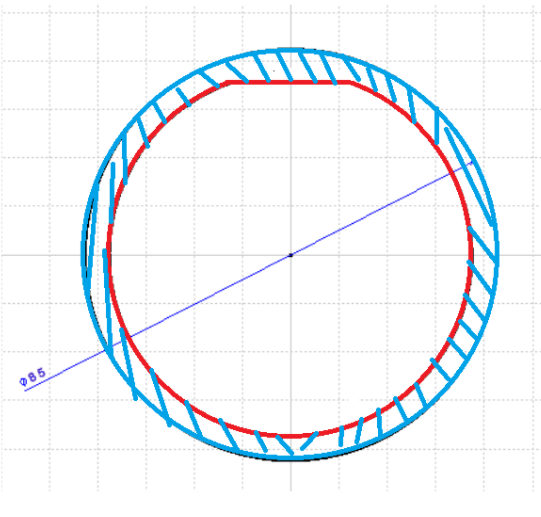
[picture p9: figure]

Numărul de ordine s, i denumirea operat, iei

Schit,a simplificată a operat, iei Utilaj, scule, dispozitive s, i SDV- uri (tip)

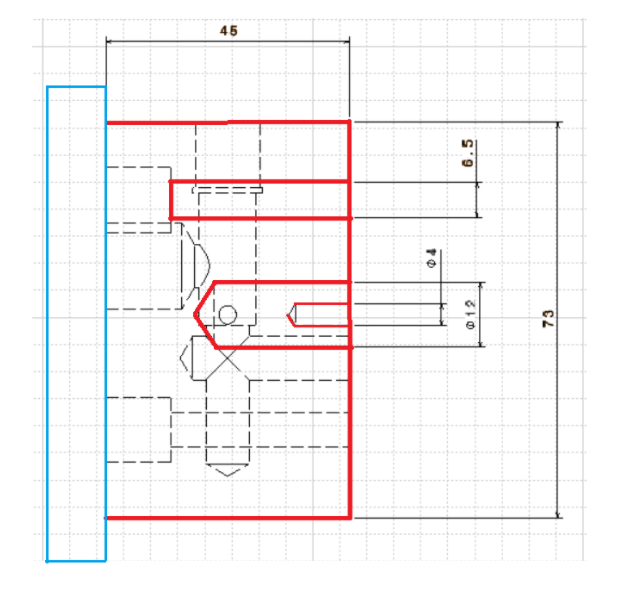
[picture p10: figure]

10 - Strunjire

U: Strung CNC
S: Burghiu, Burgiu de centruire, Tarod, Cut, it de retezare, Freză, Tarod
V: S, ubler, Micrometru

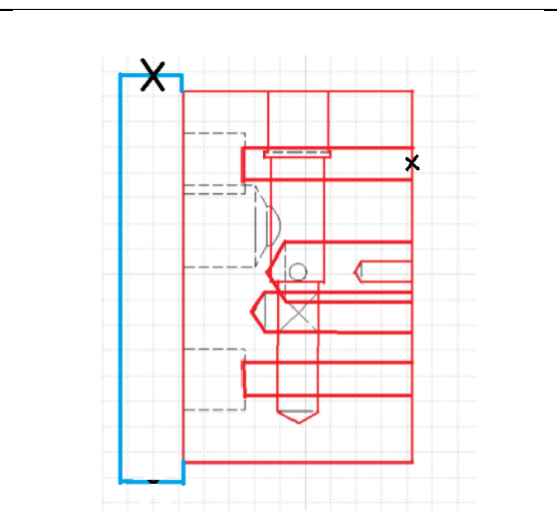
[picture p11: figure]
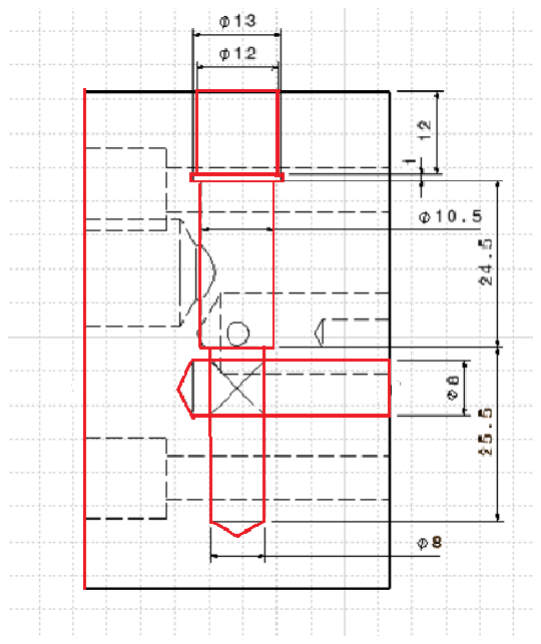
[picture p12: figure]
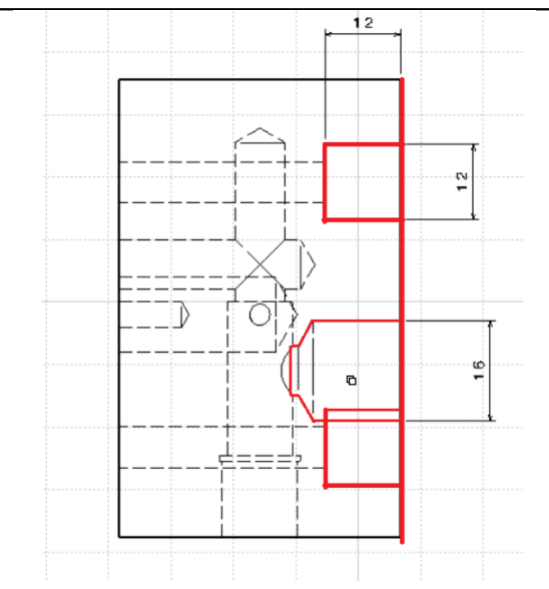
[picture p13: figure]

20 - Strunjire | | U: Strung CNC S: Cut, it de strunjire, Burgiu de centru-ire ,Burghiu D: Menghină V: S, ubler, riglă, Rugozimetru

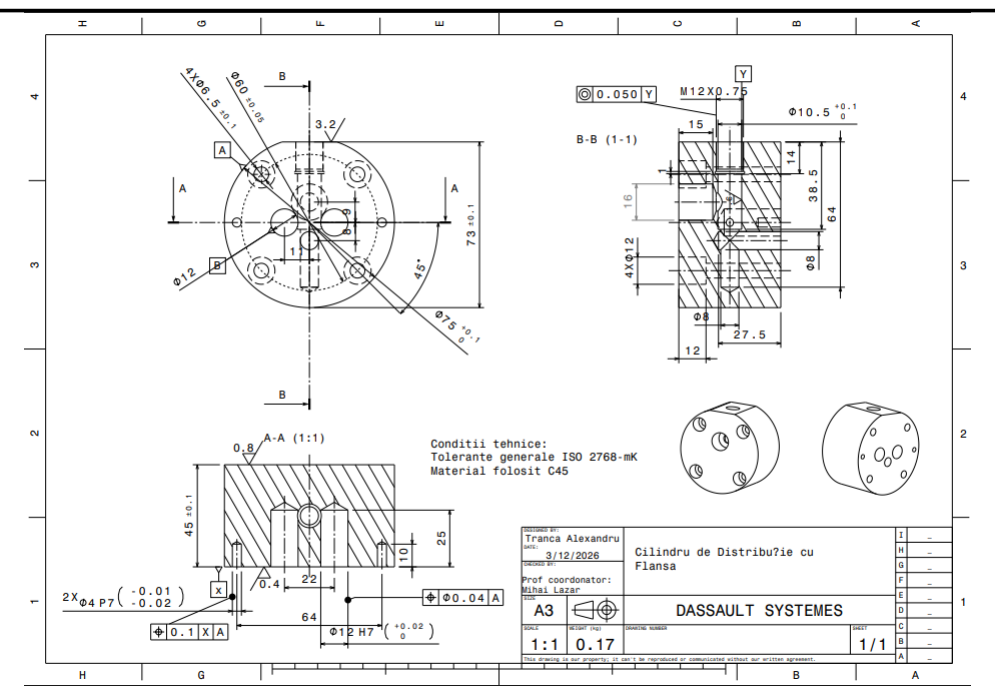
[picture p14: figure]

30 -Inspect, ie statistică / finală | | U: Masă de control V: Rugozimetru, Comparator, Aparat CMM, Calibre tampon, Riglă
60 - Conservare s, i depozitare | — | U: Instalat, ie gresare anticorozivă D: Cutii/Palet, i standard

## 6 Alegerea sculelor, dispozitivelor s, i determinarea regimurilor de as, chiere

Pentru prelucrarea reperului ”

Cilindru de Distribut, ie cu Flans,ă” din ot,el C45, procesul tehnologic a fost structurat pe operat, ii s, i faze, utilizând mas, ini-unelte cu comandă numerică (CNC). Alegerea sculelor s-a realizat din catalogul producătorului Sandvik Coromant, garantând precizia dimensională s, i rugozităt, ile impuse de desenul de execut, ie.
În tabelul de mai jos este prezentat planul detaliat al operat, iilor, respectând structura s, i succesiunea fazelor de prelucrare, fixarea s, i sculele as,chietoare aferente fiecărei etape.

Tabelul 5.1. Planul de operat, ii (Sinteza itinerariului tehnologic)

Numărul de ordine s, i denumirea operat, iei | Schit,a simplificată a operat, iei | Utilaj, dispozitive, scule s, i SDV-uri (tip)
00 - Laminare | - | U: Cilindru de laminare S: -D: -V: S, ubler, Riglă

10 - Prelucrare
Complexă 1 (Strunjire
s, i Frezare CNC)
10.1. Strunjire de
degros,are pe fat,a frontală
10.2. Frezare profil lateral superior
10.3. Centruire orificii de pe fat,ă
10.4. Găurire 4 orificii
frontale (ϕ6.5)
10.5. Găurire 2 orificii
frontale (ϕ12)
10.6. Găurire 2 orificii
frontale (ϕ4)
10.7. Strunjire frontală s, i laterală de finisare (Ra
0.8)

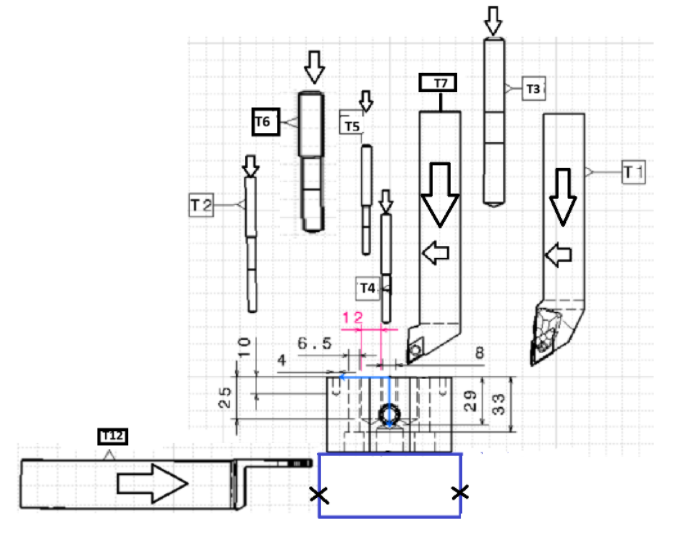
[picture p15: figure]

U: Strung CNC (cu scule antrenate / axă Y)
D: Universal cu 3 bacuri
S:
- Portcut, it degros,are
- Freză deget
- Burghiu de centruire
- Burghie din carbură
- Portcut, it finisare
V: S, ubler digital, Micrometru, Calibru tampon

Numărul de ordine s, i denumirea operat, iei | Schit,a simplificată a operat, iei | Utilaj, scule, dispozitive s, i SDV-uri (tip)

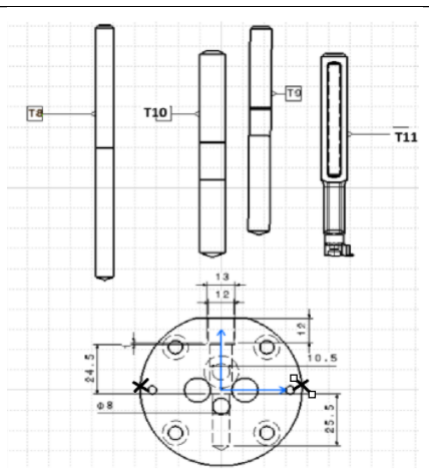
[picture p16: figure]

10.8. Găurire centrală (ϕ8) 10.9. Găurire centrală (ϕ10.5) 10.10. Găurire centrală (ϕ12) 10.11. Găurire centrală (ϕ13) 10.12. Retezare finală a piesei | | U: Strung CNC (cu scule antrenate / axă Y) D: Universal cu 3 bacuri S: - Burghie din carbură - Bară de canelare interioară - Portcut, it de retezare V: S, ubler digital, Micrometru, Calibru tampon
20 - Prelucrare Complexă 2 20.1. Prindere semifabricat (întoarcere) 20.2. Strunjire frontală de finisare (Ra 0.8) 20.3. Centruire orificii de pe spate 20.4. Găurire centrală(ϕ12) 20.5. Găurire centrală(ϕ8) 20.6. Găurire centrală(ϕ16) | | U: Strung CNC D: Universal cu 3 bacuri (fălci moi) S: - Portcut, it finisare - Burghiu de centruire - Burghie din carbură V: S, ubler digital, Rugozimetru, Calibru tampon

25 - Inspect, ie finală

30 - Conservare s, i depozitare

## 6.1. Utilaje s, i SDV-uri, metodele s, i procedeele de reglare la dimensiune

### 6.1.1. Utilaje

Pe baza analizei capitolelor precedente s, i a succesiunii operat, iilor stabilite în tabelul 5.1, tabelul 5.2 cuprinde centralizarea s, i descrierea detaliată a utilajelor selectate pentru realizarea procesului tehnologic.

Tabelul 5.2. Utilaje s, i caracteristicile acestora

Numărul de ordine s, i denumirea operat, iei | Tip utilaj | Marca utilaj | Caracteristici tehnice
00 - Laminare | Cilindru de laminare | - | -

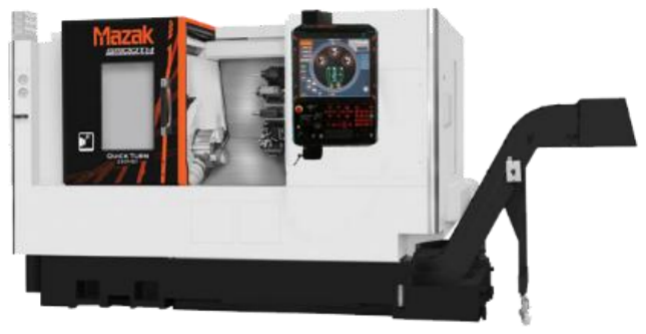
[picture p17: figure]

10 - Prelucrare
Complexă 1

MAZAK Quick
Turn 250
- Maximum Swing 26.50
in / 675 mm
- Maximum Machining
Diameter 14.750 in /
380 mm
- Maximum Bar Work
Capacity 3.0 in / 65 mm
- Maximum Machining
Length 21.275 in / 541
mm
- Chuck Size 10 in / 254
mm
- Maximum Speed 4000
rpm
- Motor Output 35.0 hp /
26 kw
- Chuck Size 6 in / 152
mm

20 - Prelucrare
Complexă 2

MAZAK Quick
Turn 250 | -
- Maximum Speed 6000
rpm
- Motor Output 15.0 hp /
11 kw
- Number of Tools 12
- Maximum Speed 6000
rpm
- Motor Output 10.0 hp /
8 kw
- Travel (X Axis) 9.00 in
/ 230 mm
- Travel (Y Axis) 4.00 in
/ 102 mm
- Travel (Z Axis) 22.63 in / 575 mm
- Travel (W Axis) 23.00
in / 585 mm

Numărul de ordine s, i denumirea operat, iei | Tip utilaj | Marca utilaj | Caracteristici tehnice
25 - Inspect, ie statistică intermediară | Banc de lucru modular Hoffmann | | • Lungime banc [mm] 1120 • Latime banc [mm] 650 • Dimensiuni panou [mm] 1120x550 • Numar dulapuri [buc] 1 • Numar sertare [buc] 5 • Numar prize [buc] 4 • Roti Nu

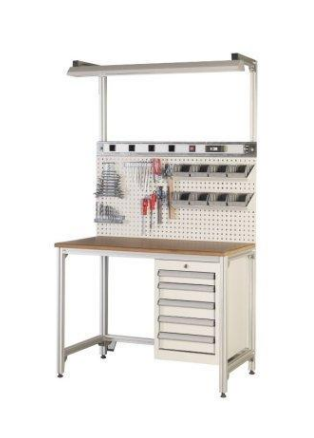
[picture p18: figure]

### 6.1.2 Dispozitive port-piesă (DPP)

Conform reperului, în tabelul următor se stabilesc dispozitivele de prindere ale piesei, t, inând cont de operat, iile procesului tehnologic s, i de schemele de orientare s, i fixare utilizate.

Tabel 5.3. Dispozitive port-piesă utilizate în procesul tehnologic CNC

Nr. Op. | Denumire operat, ie | Dispozitiv port-piesă
00 | Laminare | -
10 | Strunjire | DS-10
20 | Strunjire | DS-20
30 | Inspect, ie finală | -
40 | Conservare – depozitare | -

### 6.1.3 Scule s, i dispozitive port-sculă (SDPS)

Pentru fiecare operat, ie în parte s-au determinat, în funct, ie de prelucrare, de fazele acesteia, de mas, ina unealtă, sculele necesare s, i dispozitivele port-sculă ale acestora, corespunzător fiecărui proces tehnologic în parte.

Tabel 5.4. Scule s, i dispozitive port-sculă utilizate în procesul tehnologic CNC

Operat, ia | Fazele pre-lucrării | Simbol Notare / | imagine | Tip | Alte caracteristici | DPS
10. Op. Com-plexă 1 | 10.1. Strunjire de degros,are frontală | Sc1 | DDJNR 2525M 15 | Portcut, it degros,are | - Tool cutting edge angle(KAPR) 93° - Lead angle(PSIR) -3° - Clamping type code(MTP) RC clamp - Insert type(CUTINT MASTER) DNMG 150608 - Connection side(ADINTMS) Rect 25x25 | Universal cu 3 bacuri
10. Op. Com-plexă 1 | 10.2. Frezare profil lateral superior | Sc2 | CoroMill Plura 1P220-1200-XA | Freză deget ϕ12 | - Cutting diameter(DC) 12 mm - Max depth of cut(APMX) 26 mm - Cutting edge count(ZEFP) 4 - Connection side(ADINTMS) Cyl 12 | Universal cu 3 bacuri (sculă antre-nată)
10 / 20 | 10.3 / 20.3. Centruire orificii (fat,ă/spate) | Sc3 | CoroDrill 460.1-0500-025A0 | Burghiu centruire ϕ5 | - Cutting diameter(DC) 5 mm - Usable length(LU) 25 mm - Point angle(SIG) 140° - Connection side(ADINTMS) Cyl 6 | Universal cu 3 bacuri (sculă antre-nată)
10. Op. Com-plexă 1 | 10.4. Găurire 4 orificii frontale | Sc4 | CoroDrill 860.1-0650-031A1 | Burghiu carbură ϕ6.5 | - Cutting diameter(DC) 6.5 mm - Usable length(LU) 31 mm - Point angle(SIG) 140° - Connection side(ADINTMS) Cyl 8 | Universal cu 3 bacuri (sculă antre-nată)

Operat, ia | Fazele pre-lucrării | Simbol Notare / | imagine | Tip | Alte caracteristici | DPS
10 / 20 | 10.5 / 10.10 / 20.4. Găurire orificii ϕ12 | Sc5 | CoroDrill 860.1-1200-037A1 | Burghiu carbură ϕ12 | - Cutting diameter(DC) 12 mm - Usable length(LU) 37 mm - Point angle(SIG) 140° - Connection side(ADINTMS) Cyl 12 | Universal cu 3 bacuri (sculă antre-nată)
10. Op. Com-plexă 1 | 10.6. Găurire 2 orificii frontale | Sc6 | CoroDrill 860.1-0400-012A1 | Burghiu carbură ϕ4 | - Cutting diameter(DC) 4 mm - Usable length(LU) 12 mm - Point angle(SIG) 140° - Connection side(ADINTMS) Cyl 6 | Universal cu 3 bacuri (sculă antre-nată)
10 / 20 | 10.7 / 20.2. Strunjire finisare (Ra 0.8 / 0.4) | Sc7 | SDJCR 2525M 11 | Portcut, it finisare | - Tool cutting edge angle(KAPR) 93° - Lead angle(PSIR) -3° - Clamping type code(MTP) Screw - Insert type(CUTINT MASTER) DCMT 11T304 - Connection side(ADINTMS) Rect 25x25 | Universal cu 3 bacuri
10 / 20 | 10.8 / 20.5. Găurire centrală ϕ8 | Sc8 | CoroDrill 860.1-0800-065A1 | Burghiu carbură ϕ8 | - Cutting diameter(DC) 8 mm - Usable length(LU) 65 mm - Point angle(SIG) 140° - Connection side(ADINTMS) Cyl 8 | Universal cu 3 bacuri

Operat, ia | Fazele pre-lucrării | Simbol Notare / | imagine | Tip | Alte caracteristici | DPS
10. Op. Com-plexă 1 | 10.9. Găurire centrală ϕ10.5 | Sc9 | CoroDrill 860.1-1050-056A1 | Burghiu carbură ϕ10.5 | - Cutting diameter(DC) 10.5 mm - Usable length(LU) 56 mm - Point angle(SIG) 140° - Connection side(ADINTMS) Cyl 12 | Universal cu 3 bacuri
10. Op. Com-plexă 1 | 10.11. Lărgire/Canelare interioară ϕ13 | Sc10 | MB-E12-34-09 | Bară canelare interi-oară | - Min. bore diameter(DMIN) 10 mm - Max overhang(OHX) 34 mm - Insert type(CUTINT MASTER) MB-09 - Connection side(ADINTMS) Cyl 12 | Universal cu 3 bacuri
10. Op. Com-plexă 1 | 10.12. Retezare finală a piesei | Sc11 | QD-RFH33-2525A | Portcut, it retezare | - Tool cutting edge angle(KAPR) 90° - Max cutting depth(CDX) 33 mm - Insert width(CW) 4.0 mm - Insert type(CUTINT MASTER) QD-NH - Connection side(ADINTMS) Rect 25x25 | Universal cu 3 bacuri
20. Op. Com-plexă 2 | 20.6. Găurire centrală ϕ16 | Sc12 | CoroDrill 860.1-1600-049A1 | Burghiu carbură ϕ16 | - Cutting diameter(DC) 16 mm - Usable length(LU) 49 mm - Point angle(SIG) 140° - Connection side(ADINTMS) Cyl 16 | Universal cu 3 bacuri

### 6.1.4 Verificatoare

În tabelul următor sunt stabilite verificatoarele necesare pentru controlul operat, iilor din cadrul procesului tehnologic, având în vedere tipul suprafet,elor s, i precizia finală a reperului.

Tabel 5.5. Verificatoare utilizate în procesul tehnologic CNC

Operat, ia | Verificator
Tip | Dimensiuni | DiviziuneDomeniu
00. Laminare | S, ubler cu Vernier | Exterior, interior, adâncimi | 0,02 | 0–150 mm
10. Op. Complexă 1 | Micrometru exterior DIN 863 | Exterior | 0,01 | 50–75 mm
10. Op. Complexă 1 | Etalon rugozitate | Rugozităt, i | - | 0,05–12,5 µm
20. Op. Complexă 2 | Micrometru interior | Interior | 0,01 | 5–30 mm
20. Op. Complexă 2 | Etalon rugozitate | Rugozităt, i | - | 0,05–12,5 µm

Operat, ia | Verificator
Tip | Dimensiuni | DiviziuneDomeniu
35. Inspect, ie finală | Mas, ină de măsurat în coordonate (CMM) | Dimensional -geometric | - | Conform domeniului

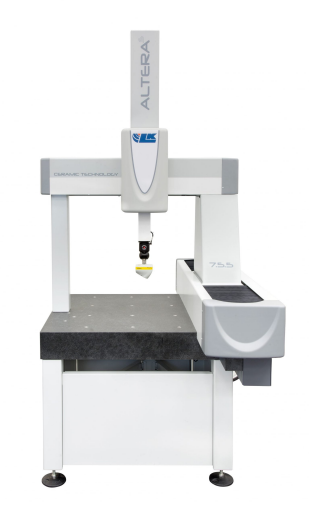
[picture p19: figure]

35. Inspect, ie finală | Palpator CNC | Pozit, ii s, i abateri | - | Conform programului
40. Conservare – depozitare | - | - | - | -

### 6.2 Metode s, i procedee de reglare a sistemelor tehnologice

Pentru realizarea operat, iilor de prelucrare pe centrul CNC este necesară stabilirea metodelor s, i procedeelor de reglare ale sistemului tehnologic, astfel încât să fie asigurate precizia dimensională s, i repetabilitatea procesului de fabricat, ie.
Reglarea la dimensiune presupune stabilirea pozit, iei sculei, a dispozitivelor s, i a sistemelor de măsurare utilizate în cadrul procesului tehnologic, în funct, ie de operat, ia executată s, i de caracteristicile suprafet,elor prelucrate.
Metoda utilizată pentru reglarea la dimensiune este metoda reglării automate, specifică prelucrărilor CNC, prin utilizarea sistemelor de măsurare s, i a compensărilor realizate direct în programul mas, inii-unelte.

### 6.3 Regimurile de prelucrare

Pentru realizarea piesei la precizia s, i calitatea prescrisă este necesară îndepărtarea adaosului de prelucrare prin operat, ii de as,chiere executate cu regimuri de prelucrare corespunzătoare. Stabilirea regimurilor de as,chiere s-a realizat în funct, ie de materialul piesei (Ot,el C45), tipul operat, iei, caracteristicile sculelor Sandvik Coromant utilizate s, i precizia dimensională impusă, astfel încât procesul tehnologic să asigure productivitate ridicată s, i un cost minim al prelucrării.

Calculul regimurilor de prelucrare

Tabel 5.6. Metode s, i procedee de reglare la dimensiune

Operat, ia | Metoda de reglare la dimensiune | Procedeul de reglare la dimensiune
10. Prelucrare Complexă 1 | Metoda reglării automate | Măsurarea sculelor prin utilizarea brat,ului palpator (Tool Eye) al centrului CNC Mazak s, i introducerea corect, iilor de sculă (offset-urilor) direct în programul mas, inii. Stabilirea originii piesei pe axa Z.
20. Prelucrare Complexă 2 | Metoda reglării automate | Reluarea originii piesei după întoarcere s, i compensarea prin program a noului zero pe axa Z utilizând palpatorul.
35. Inspect, ie finală | Metoda verificării directe | Verificarea dimensiunilor s, i a rugozităt, ii (Ra 0.8 / Ra 0.4) utilizând instrumente de măsură de precizie (s,ubler digital, micrometru, rugozimetru).

Relat, iile utilizate pentru determinarea regimurilor sunt:

f = z · fz

n =

1000 · Vc
π · d
Vf = n · f

ap =

d
2

(pentru operat, iile de găurire cu burghiu plin)

Pentru Sc2 – frezare profil lateral ∅12 (z = 4 dint, i):

f = 4 · 0, 06 = 0, 24 mm/rot

n =

1000 · 160
π · 12

= 4244 rot/min

Vf = 4244 · 0, 24 = 1018 mm/min

Pentru Sc4 – găurire ∅6, 5:

ap =

d
2

=

6, 5
2

= 3, 25 mm

n =

1000 · 120
π · 6, 5

= 5876 rot/min

Vf = 5876 · 0, 20 = 1175 mm/min

Pentru Sc5 – găurire ∅12:

ap =

d
2

=

12
2

= 6 mm

n =

1000 · 120
π · 12

= 3183 rot/min

Vf = 3183 · 0, 28 = 891 mm/min

Tabel 5.7. Regimuri de prelucrare pentru operat, iile CNC

Faza | ap | ae | fz | f | d | Vc | n | Vf
Degros,are frontală – Sc1 | 3,0 | - | - | 0,32 | 60 | 210 | 1114 | 356
Frezare profil lateral – Sc2 | 4,0 | 12,0 | 0,06 | 0,24 | 12 | 160 | 4244 | 1018
Centruire orificii – Sc3 | 2,5 | - | - | 0,15 | 5 | 100 | 6366 | 954
Găurire frontale – Sc4 | 3,25 | - | - | 0,20 | 6,5 | 120 | 5876 | 1175
Găurire ∅12 – Sc5 | 6,0 | - | - | 0,28 | 12 | 120 | 3183 | 891
Găurire ∅4 – Sc6 | 2,0 | - | - | 0,12 | 4 | 120 | 9549 | 1145
Strunjire finisare – Sc7 | 0,5 | - | - | 0,10 | 60 | 280 | 1485 | 148
Găurire centrală – Sc8 | 4,0 | - | - | 0,22 | 8 | 120 | 4774 | 1050
Găurire centrală – Sc9 | 5,25 | - | - | 0,25 | 10,5 | 120 | 3637 | 909
Canelare interioară – Sc10 | 0,5 | - | - | 0,08 | 13 | 140 | 3427 | 274
Retezare piesă – Sc11 | 4,0 | - | - | 0,12 | 30 | 160 | 1697 | 203
Găurire ∅16 – Sc12 | 8,0 | - | - | 0,32 | 16 | 120 | 2387 | 763
[mm] | [mm] | [mm/dinte][mm/rot] | [mm] | [m/min] [rot/min] [mm/min]

Pentru Sc1 – strunjire de degros,are frontală (calculat la ∅mediu60 mm):

n =

1000 · 210
π · 60

= 1114 rot/min

Vf = 1114 · 0, 32 = 356 mm/min

Pentru Sc12 – găurire ∅16:

ap =

d
2

=

16
2

= 8 mm

n =

1000 · 120
π · 16

= 2387 rot/min

Vf = 2387 · 0, 32 = 763 mm/min

# 7 Programarea mas, inilor-unelte cu comandă numerică

## 7.1 Definirea semifabricatului s, i a piesei în contextul simulării CAM

Pentru realizarea simulării CAM în mediul SolidWorks au fost definite atât modelul piesei finite, cât s, i modelul semifabricatului utilizat în procesul de prelucrare. Configurarea init, ială s-a realizat pe baza dimensiunilor stabilite anterior în cadrul calculelor tehnologice s, i al desenului de execut, ie. În etapa de simulare, piesa finită a fost suprapusă peste semifabricat pentru a evident, ia zonele în care urmează să fie îndepărtat materialul în timpul operat, iilor de as,chiere. Cele două modele au fost pozit, ionate utilizând acelas, i sistem de coordonate s, i aceeas, i origine tehnologică, asigurând astfel o orientare corectă a reperului în raport cu mas, ina-unealtă s, i cu sculele utilizate.
Semifabricatul a fost reprezentat în mediul CAM printr-o culoare diferită s, i cu un anumit grad de transparent,ă, pentru a permite observarea clară a diferent,elor dintre geometria init, ială s, i forma finală a piesei. Prin această metodă se poate identifica vizual adaosul de prelucrare necesar obt, inerii suprafet,elor s, i dimensiunilor finale.

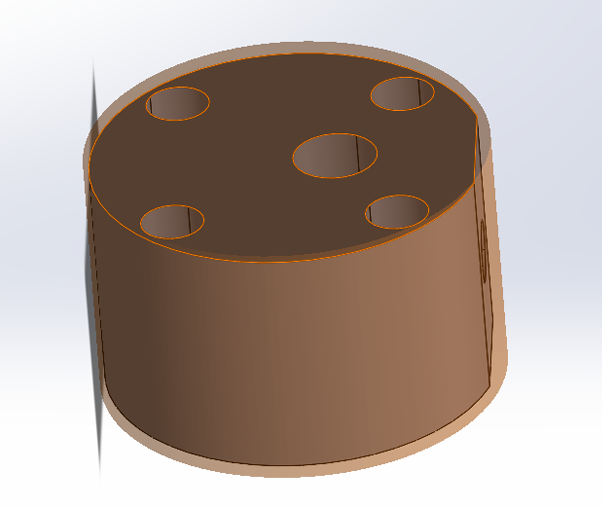
[picture p20: figure]

Figura 12: Suprapunerea piesei finite peste semifabricat în mediul CAM

## 7.2 Fixarea piesei s, i definirea sistemului de coordonate

Fixarea piesei s, i stabilirea sistemului de coordonate reprezintă o etapă esent, ială în pregătirea simulării CAM, deoarece influent,ează direct corectitudinea traseelor de sculă s, i precizia prelucrării. Înainte de generarea operat, iilor, piesa trebuie pozit, ionată corect fat,ă de semifabricat, dispozitivul de prindere s, i sistemul de referint,ă al mas, inii-unelte.
În mediul SolidWorks CAM, piesa finită a fost suprapusă peste semifabricat, astfelîncât adaosurile de prelucrare să fie vizibile s, i us,or de analizat. Semifabricatul a fost reprezentat transparent, pentru a permite observarea diferent,elor dintre forma init, ială s, i geometria finală a reperului.
Sistemul de coordonate al dispozitivului de fixare a fost definit prin opt, iunea Coordinate System. Originea a fost stabilită într-un punct de referint,ă al piesei, utilizând opt, iunea Part bounding box center. Această alegere permite raportarea clară a deplasărilor sculei fat,ă de piesă s, i semifabricat.

Axa X a fost orientată după direct, ia longitudinală principală a piesei, iar axa Y după direct, ia transversală. Axa Z este perpendiculară pe suprafat,a superioară a piesei s, i corespunde direct, iei de apropiere s, i retragere a sculei. Prin această definire, planul XY devine planul principal de prelucrare, iar operat, iile CAM pot fi generate în raport cu suprafat,a superioară a reperului.

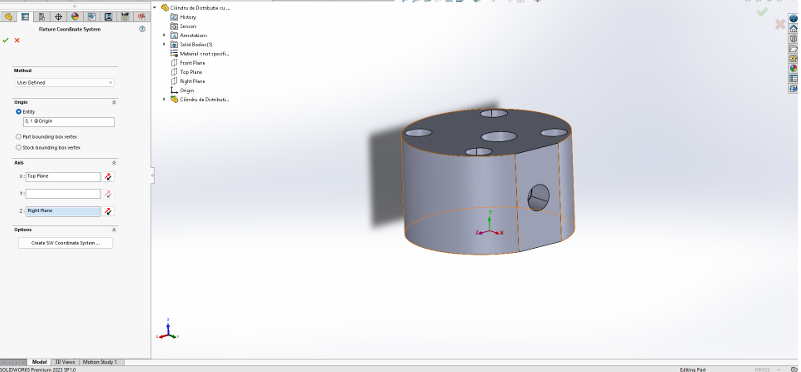
[picture p21: figure]

Figura 13: Definirea sistemului de coordonate al dispozitivului de fixare în SolidWorks CAM

Definirea corectă a sistemului de coordonate reduce riscul aparit, iei erorilor de pozit, ionare în timpul simulării s, i permite generarea traseelor de sculă într-un mod controlat. Totodată, aceasta asigură o legătură clară între modelul CAD, semifabricat s, i operat, iile CNC realizate în mediul CAM.

# 8 Programarea mas, inilor-unelte cu comandă numerică

## 8.1 Cod NC generat pentru prima pozit, ionare a piesei

Codul NC prezentat în continuare a fost obt, inut în urma post-procesării traseelor de sculă, simulând ies, irea unui sistem CAM integrat. Acesta corespunde primei pozit, ionări a piesei, în care suprafat,a superioară s, i profilul exterior sunt accesibile sculelor. Sunt realizate operat, iile de strunjire de degros,are (în treceri multiple), frezarea profilului lateral cu scule antrenate pe mai multe niveluri de adâncime (Z-level), găuririle frontale, găuririle centrale adânci, canelarea interioară s, i retezarea finală a piesei. Regimurile de as,chiere (avansurile s, i turat, iile) apelează strict valorile calculate tehnologic anterior.

Listing 1: Cod NC extins generat pentru prima pozit, ionare a piesei

O1000 (SIMULARE CAM - OPERATIA 10 - MAZAK QTN 250MY)
N5 G21 G40 G80 G99 (METRIC, CANCEL COMP, CANCEL CYCLE, IPR) N10 G54 (WORK OFFSET 1)
N15 (=========================================)
N20 ( FAZA 10.1: SCULA 1 - DEGROSARE EXTERIOARA )
N25 ( SCULA: DDJNR 2525M 15 - PLACUTA: DNMG ) N30 (=========================================) N35 G91 G28 X0 Y0 Z0
N40 T0101 M06
N45 G50 S2500 (MAX RPM LIMIT)
N50 G96 S210 M03 (CSS ON, 210 M/MIN, SPINDLE CW) N55 G90 G00 X65. Z5. M08 (APPROACH & COOLANT ON) N60 G00 Z0.
N65 G01 X-1.5 F0.32 (FACE CUT)
N70 G00 X65. Z2.
N75 (CICLU G71 DEGROSARE PE Z - TRECERI MULTIPLE)
N80 G71 U2.0 R0.5 (ADANCIME TAIERE 2MM, RETRAGERE 0.5MM) N85 G71 P90 Q220 U0.5 W0.2 F0.32 (LASA ADAOS 0.5 X SI 0.2 Z) N90 G00 X15.
N95 G01 X20. Z0. F0.20
N100 G01 X20. Z-12.5 F0.32
N105 G02 X26. Z-15.5 R3. (FILLET RADIUS) N110 G01 X36. Z-15.5
N115 G01 X40. Z-17.5 (CHAMFER)
N120 G01 X40. Z-30.
N125 G03 X44. Z-32. R2. (FILLET RADIUS) N130 G01 X48. Z-32.
N135 G01 X50. Z-33. (CHAMFER)
N140 G01 X50. Z-45.
N145 G02 X56. Z-48. R3.
N150 G01 X58. Z-48.
N155 G01 X60. Z-49. (CHAMFER) N160 G01 X60. Z-60.
N165 G01 X62. Z-60.
N170 G00 X65.
N175 (END OF CONTOUR DEFINITION)

N180 G00 X65. Z5. M09
N185 G91 G28 X0 Y0 Z0
N190 M05 (SPINDLE STOP)

N195 (=========================================) N200 ( FAZA 10.7: SCULA 7 - FINISARE EXTERIOARA ) N205 ( SCULA: SDJCR 2525M 11 - PLACUTA: DCMT ) N210 (=========================================) N215 T0707 M06
N220 G50 S3000
N235 G96 S280 M03 (CSS ON, HIGH SPEED FINISHING)
N240 G90 G00 X65. Z2. M08
N245 G70 P90 Q170 F0.10 (EXECUTA PROFILUL P90-Q170 LA F0.10) N250 G00 X65. Z5. M09
N255 G91 G28 X0 Y0 Z0
N260 M05

N265 (=========================================) N270 ( FAZA 10.2: SCULA 2 - FREZARE 2.5D PROFIL ) N275 ( SCULA: CoroMill Plura 1P220-1200 - D12 ) N280 (=========================================) N285 M200 (MILLING MODE ENGAGE)
N290 G28 H0 (C-AXIS ZERO RETURN)
N295 T0202 M06
N300 G97 S4244 M203 (LIVE TOOL START, 4244 RPM) N305 G90 G00 X65. Y25. Z10. M08
N310 G00 Z2.
N315 (Z-LEVEL ROUGHING PASS 1 - Z-1.5)
N320 G01 Z-1.5 F1018.
N325 G01 X40. Y20.
N330 G03 X30. Y10. R10.
N335 G01 X30. Y-10.
N340 G03 X40. Y-20. R10.
N345 G01 X65. Y-25.
N350 G00 X65. Y25.
N355 (Z-LEVEL ROUGHING PASS 2 - Z-3.0) N360 G01 Z-3.0 F1018.
N365 G01 X40. Y20.
N370 G03 X30. Y10. R10.
N375 G01 X30. Y-10.
N380 G03 X40. Y-20. R10.
N385 G01 X65. Y-25.
N390 G00 X65. Y25.
N395 (Z-LEVEL FINISHING PASS 3 - Z-4.0) N400 G01 Z-4.0 F1018.
N405 G01 X39.8 Y19.8 (COMPENSARE UZURA) N410 G03 X29.8 Y9.8 R10.
N415 G01 X29.8 Y-9.8
N420 G03 X39.8 Y-19.8 R10.
N425 G01 X65. Y-25.

N430 G00 Z10. M09
N435 G91 G28 X0 Y0 Z0
N440 M205 (LIVE TOOL STOP)

N445 (=========================================)
N450 ( FAZA 10.3/10.4: SCULA 3 & 4 - GAURIRI FRONTAL )
N455 ( SCULA 3: CENTRUIRE D5 | SCULA 4: BURGHIU D6.5 )
N460 (=========================================)
N465 T0303 M06 (CENTRUIRE)
N470 G97 S6366 M203
N475 G90 G00 X30. C0. Z5. M08
N480 G81 Z-2.5 R2. F954. (CICLU CENTRUIRE G81) N485 C90.
N490 C180.
N495 C270.
N500 G80 Z5. M09
N505 G91 G28 X0 Y0 Z0
N510 T0404 M06 (GAURIRE BURGHIU PLIN)
N515 G97 S5876 M203
N520 G90 G00 X30. C0. Z5. M08
N525 G83 Z-15. R2. Q3. F1175. (CICLU G83 DESCARCARE SPAN DEEP HOLE) N530 C90.
N535 C180.
N540 C270.
N545 G80 Z5. M09
N550 G91 G28 X0 Y0 Z0

N555 (=========================================)
N560 ( FAZA 10.5/10.6: SCULA 5 & 6 - GAURIRE D12 & D4 ) N565 (=========================================)
N570 T0505 M06 (BURGHIU D12 FRONT)
N575 G97 S3183 M203
N580 G90 G00 X40. C45. Z5. M08
N585 G83 Z-20. R2. Q4. F891. N590 C225.
N595 G80 Z5.
N600 G91 G28 X0 Y0 Z0
N605 T0606 M06 (BURGHIU D4 FRONT) N610 G97 S9549 M203
N615 G90 G00 X20. C135. Z5. M08 N620 G83 Z-12. R2. Q2. F1145. N625 C315.
N630 G80 Z5. M09
N635 G91 G28 X0 Y0 Z0
N640 M205
N645 M201 (TURNING MODE ENGAGE)

N650 (=========================================)
N655 ( FAZA 10.8/10.9: SCULE 8 & 9 - GAURIRI CENTRALE ) N660 (=========================================)

N665 T0808 M06 (BURGHIU CARBURA STATIC D8) N670 G97 S4774 M03
N675 G90 G00 X0. Z5. M08
N680 G83 Z-35. R2. Q4. F0.22 (FEED PER REV) N685 G80 Z5. M09
N690 G91 G28 X0 Y0 Z0
N695 T0909 M06 (BURGHIU CARBURA STATIC D10.5) N700 G97 S3637 M03
N705 G90 G00 X0. Z5. M08
N710 G83 Z-25. R2. Q4. F0.25
N715 G80 Z5. M09
N720 G91 G28 X0 Y0 Z0

N725 (=========================================)
N730 ( FAZA 10.11: SCULA 10 - CANELARE INTERIOARA D13 )
N735 ( SCULA: BARA MB-E12-34-09 | )
N740 (=========================================)
N745 T1010 M06
N750 G96 S140 M03
N755 G90 G00 X10.5 Z2. M08 (INTRARE SIGURA IN GAURA) N760 G01 Z-15. F0.20
N765 G01 X11.5 F0.08 (TRECERE 1)
N770 G01 Z-10.
N775 G01 X10.5
N780 G00 Z-15.
N785 G01 X12.5 F0.08 (TRECERE 2) N790 G01 Z-10.
N795 G01 X10.5
N800 G00 Z-15.
N805 G01 X13.0 F0.05 (FINISARE CANAL D13) N810 G01 Z-10.
N815 G01 X10.5
N820 G00 Z5. M09
N825 G91 G28 X0 Y0 Z0

N830 (=========================================)
N835 ( FAZA 10.12: SCULA 11 - RETEZARE FINALA | )
N840 (=========================================)
N845 T1111 M06
N850 G50 S1500
N855 G96 S160 M03
N860 G90 G00 X65. Z-65. M08 (POZITIE DE DEBITARE) N865 G01 X20. F0.12
N870 G00 X22. (DESCARCARE SPAN/RETRACT MICA)
N875 G01 X10. F0.12
N880 G00 X12.
N885 G01 X-1.5 F0.08 (RETEZARE COMPLETA SPRE CENTRU) N890 G00 X65. M09
N895 G91 G28 X0 Y0 Z0
N900 M05

N905 M30 (END OF PROGRAM)

## 8.2 Cod NC generat pentru a doua pozit, ionare a piesei

După efectuarea primei etape, piesa este debitată s, i rotită cu 180 de grade. Pentru a se evita deteriorarea rugozităt, ii de suprafat,ă obt, inute anterior, prinderea în această etapă (Operat, ia 20) se face în universal utilizând fălci moi, uzinate la diametrul specific al reperului. În această pozit, ionare se execută corect, ia lungimii totale prin strunjire frontală fină s, i se procesează prelucrările de centruire s, i găurire pe suprafat,a din spate a piesei.

Listing 2: Cod NC extins generat pentru a doua pozit, ionare a piesei

O2000 (SIMULARE CAM - OPERATIA 20 - MAZAK QTN 250MY)
N5 G21 G40 G80 G99
N10 G55 (WORK OFFSET 2 - PRINDERE IN BACURI MOI)

N15 (=========================================)
N20 ( FAZA 20.2: SCULA 7 - STRUNJIRE FRONTALA FINISARE) N25 ( SCULA: SDJCR 2525M 11 - PLACUTA: DCMT )
N30 (=========================================)
N35 G91 G28 X0 Y0 Z0
N40 T0707 M06
N45 G50 S3000
N50 G96 S280 M03
N55 G90 G00 X65. Z2. M08
N60 G00 Z0.2
N65 G01 X-1.5 F0.10 (FACE CUT SEMI-FINISH) N70 G00 X65. Z2.
N75 G00 Z0.0 (COTA ZERO REALA)
N80 G01 X-1.5 F0.08 (FACE CUT FINISH - RA 0.4) N85 G00 X58. Z1.
N90 G01 X60. Z-1. F0.10 (TESIRE MUCHIE C1) N95 G00 X65. Z5. M09
N100 G91 G28 X0 Y0 Z0
N105 M05

N110 (=========================================) N115 ( FAZA 20.3: SCULA 3 - CENTRUIRE BAZA SPATE ) N120 (=========================================) N125 T0303 M06 (BURGHIU CENTRUIRE D5 - STATIC)
N130 G97 S6366 M03
N135 G90 G00 X0. Z2. M08
N140 G01 Z-2.5 F0.15 (G01 IN LOC DE G81 PT O SINGURA GAURA) N145 G00 Z5. M09
N150 G91 G28 X0 Y0 Z0

N155 (=========================================)
N160 ( FAZA 20.5: SCULA 8 - GAURIRE D8 | )
N165 (=========================================) N170 T0808 M06
N175 G97 S4774 M03

N180 G90 G00 X0. Z2. M08
N185 G83 Z-20. R2. Q4. F0.22 (DEEP HOLE PECK DRILL) N190 G80 Z5. M09
N195 G91 G28 X0 Y0 Z0

N200 (=========================================)
N205 ( FAZA 20.4: SCULA 5 - GAURIRE D12 | )
N210 (=========================================) N215 T0505 M06
N220 G97 S3183 M03
N225 G90 G00 X0. Z2. M08
N230 G83 Z-15. R2. Q4. F0.28 N235 G80 Z5. M09
N240 G91 G28 X0 Y0 Z0

N245 (=========================================) N250 ( FAZA 20.6: SCULA 12 - GAURIRE LARGIRE D16 ) N255 (=========================================) N260 T1212 M06
N265 G97 S2387 M03
N270 G90 G00 X0. Z2. M08
N275 G83 Z-10. R2. Q5. F0.32 N280 G80 Z5. M09
N285 G91 G28 X0 Y0 Z0
N290 M05
N295 M30 (END OF PROGRAM)
