trancaalex19/Prelucrarea-mecanic-i-simularea-CAM-pentru-un-cilindru-de-distribu-ie-/(list of files, cad)

Other CAD files:
Cilindru de Distributie cu Flansa.CATPart
