trancaalex19/Prelucrarea-mecanic-i-simularea-CAM-pentru-un-cilindru-de-distribu-ie-/Desen de executie.pdf

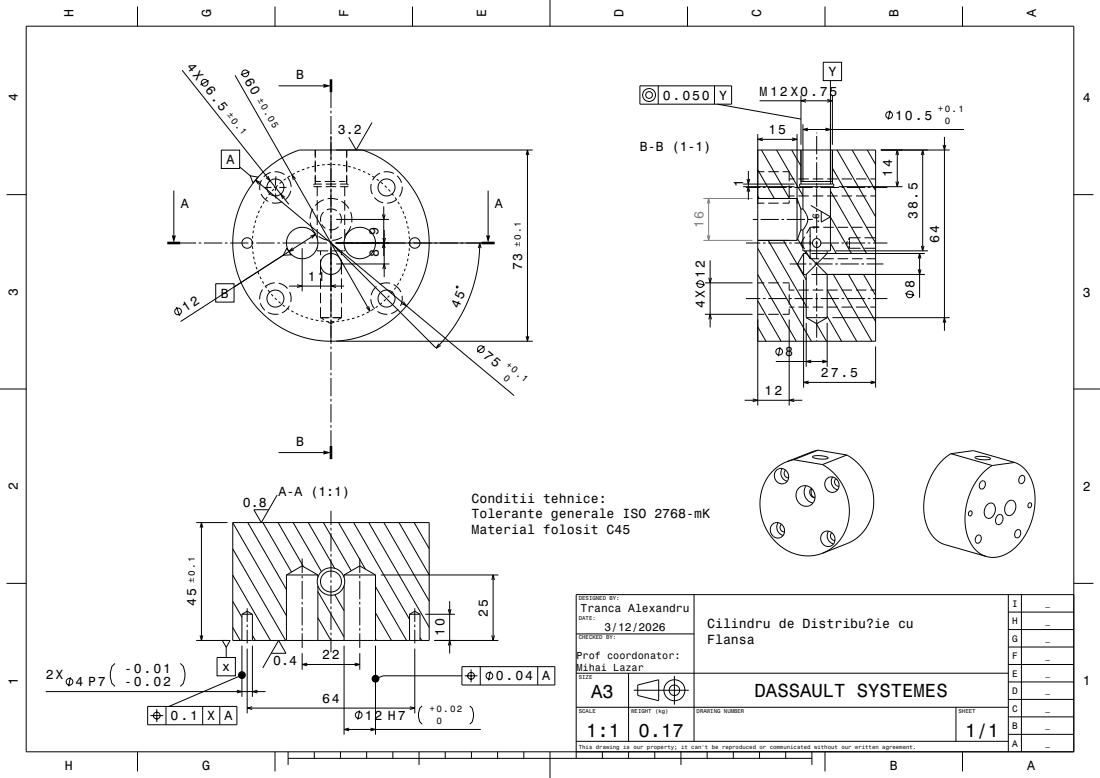
[picture p22: page 1]
WEIGHT (kg); DRAWING NUMBER; SHEET; DASSAULT SYSTEMES; CHECKED BY: Prof coordonator: Mihai Lazar

Conditii tehnice:
Tolerante generale ISO 2768-mK
Material folosit C45

DESIGNED BY: Tranca Alexandru DATE: 3/12/2026 | Cilindru de Distribu?ie cu Flansa | I | _

This drawing is our property; it can't be reproduced or communicated without our written agreement.
