trancaalex19/Prelucrarea-mecanic-i-simularea-CAM-pentru-un-cilindru-de-distribu-ie-/semifabricat.pdf

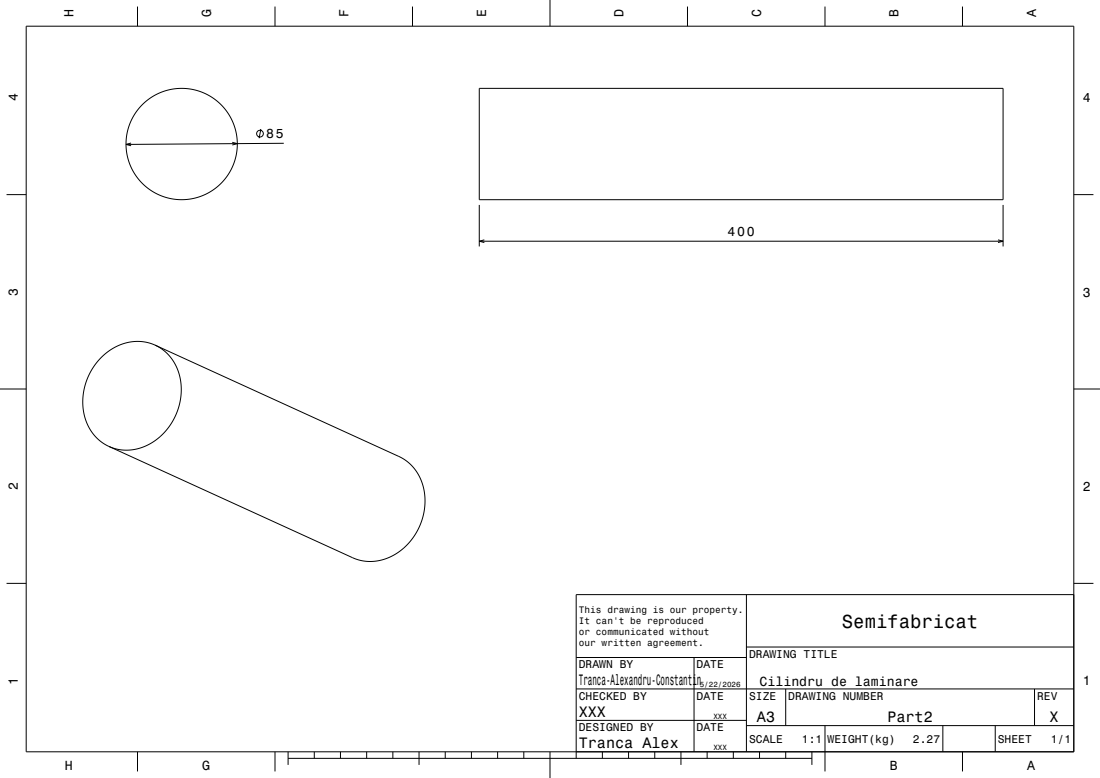
[picture p23: page 1]
DRAWN BY; DATE; DRAWING TITLE; Tranca-Alexandru-Constantin; Cilindru de laminare

This drawing is our property.
It can't be reproduced
or communicated without
our written agreement.

CHECKED BY XXX | DATE XXX | SIZE A3 | DRAWING NUMBER Part2 | REV X

DESIGNED BY Tranca Alex | DATE XXX

SCALE 1:1 | WEIGHT(kg) 2.27 | SHEET 1/1
